voloviq/Laboratory_Power_Supply/Component_View/Lcd_Nokia_Navigator_Connector/DSCF1005.JPG

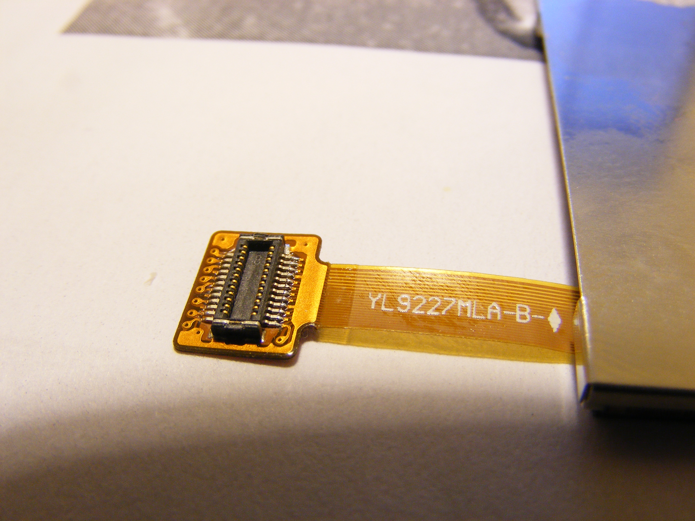
Component_View/Lcd_Nokia_Navigator_Connector/DSCF1005.JPG
