voloviq/Laboratory_Power_Supply/Software/Lcd_Menu/Key_And_Action.odt

Key and Actions functional description

Abstraction:

Function is responisble for analyze keyboard action and should take necessary preparation to proper manage menu structures of the device.

k_array[0] == 1 means pressed button number 1 (Menu)

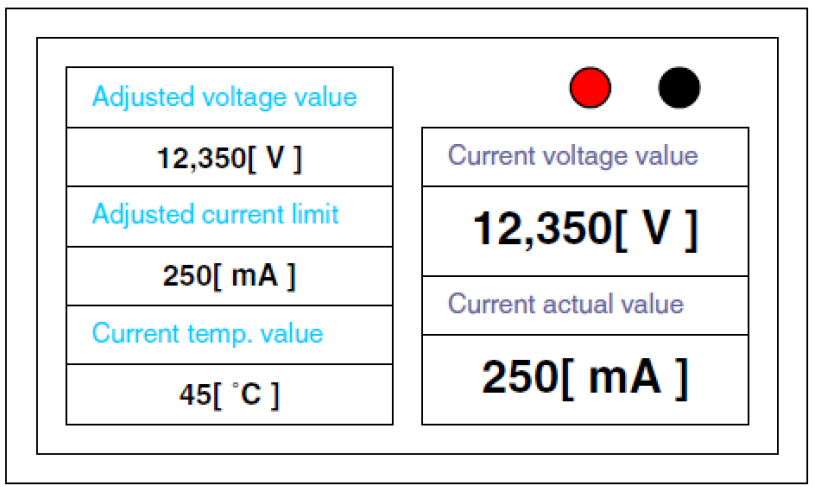
[picture p2: figure]

wr_sequencer == 0 means on display is exposed main menu structure

Algorithm:

Start

wr_sequencer == 1 means on display is exposed adjustable menu if ( wr_sequencer == 1 ) ClrScr(wr_sequencer); wr_sequencer++; if ( wr_sequencer == 0 ) if ( k_array[0] == 1 ) Function Key_state(...) take current keyboard action and storage it to k_array variable

Yes

Yes

No

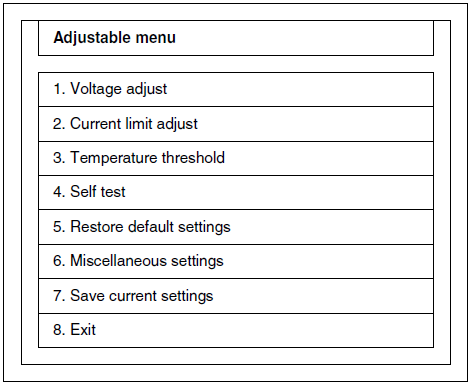
[picture p3: figure]

Show adjustable menu ClrScr(wr_sequencer); wr_sequencer = 0; Stop - Exit Show main menu if ( k_array[1] == 1 ) if ( k_array[2] == 1 ) if ( wr_sequencer == 2 )

No

No

Yes

No
