voloviq/Laboratory_Power_Supply/Software/Lcd_Menu/Key_And_Action_Algorithm_Block_Screen_C_Code.odt

Key and Actions functional description

Abstraction:

Function is responsible for analyze keyboard action and should take necessary preparation to proper manage menu structures of the device.

Screen 1Block screen relation between functional keys and LCD screens.

Complete dialog box is depicted below:

Menu - button Menu + button Menu + button Menu - button Menu + button Menu - button Menu + button Menu - button Menu - button Menu + button Menu - button Menu + button Menu + button Menu - button Menu + button Menu - button Save current settings Miscellaneous settings Restore def. settings Self test Temp. threshold Current limit Voltage Setup

Save

Misc.

Restore

Start test

85 [ºC]

12,5 [mA]

12,5 [V]


Screen 2

Screen 3

Screen 8

Screen 4

Screen 7

Screen 5

Screen 6

Screen 1 view explanation:

Current voltage measured on supply pins

Adjusted voltage value

Adjusted voltage

12,5 [V]

Current limit

200 [mA/A]

Temp 2N Trans.

85 [ºC]

Current voltage

Actual current

12,5 [V]

250[mA]

Adjusted current limit

Actual value of current which external device get from supply Temperature of 2N3055 main power transistor

Remark:

Only keys “menu +” and “menu -” work for this screen.

Screen 2 view explanation:

Key action befor „Menu +” First adjustable menu

Setup voltage

Voltage setup

12,5 [V]

Voltage setup To adjust first digit use „+” button and to change digit value use „Menu+” or „Menu-”. If You want to go back to previous screen press button „-”

12,5 [V]

To adjust second digit use „+” button and to change digit value use „Menu+” or „Menu-”. If You want to go back to previous digit press button „-”

Voltage setup

12,5 [V]

Voltage setup To adjust third digit use „+” button and to change digit value use „Menu+” or „Menu-”. If You want to go back to previous digit press button „-”

12,5 [V]

If type „+” button four time exist menu change and ask to save or not adujsted value. To save adujsted value type „+” button or „-” to discard. If you go to next screen type „Menu-” or „Menu+”

Do You want save adjustment

12,5 [V]

Remark:

Adjusted voltage may change according to range from 1[V] up to 30[V] with step 0,5 [V].
