voloviq/Laboratory_Power_Supply/External_Box_View/Front_Panel.pdf

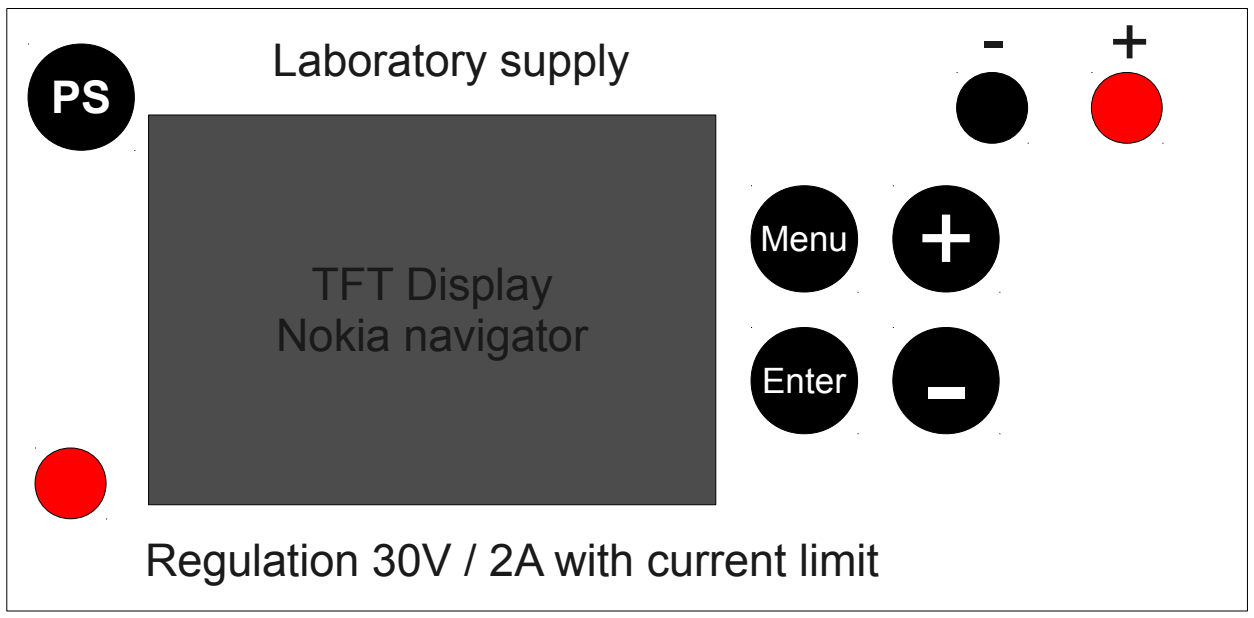
[picture p8: figure]
TFT Display Nokia navigator; Menu; Enter; Laboratory supply; Regulation 30V / 2A with current limit
