voloviq/Laboratory_Power_Supply/Software/Lcd_Connection/Lcd_Connection.pdf

## TFT Nokia Navigator Display

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
