voloviq/Laboratory_Power_Supply/Designing_Plan/Designing_Plan.xls

Enumerate | Topic | Necessary stuff | Necessary time to do | Remarks | Delay | Work complete
1 | Check Nokia N73 Display connector - detect where is located signals on connector | Display N73 + N73 Connector + Supplier | 2h | - | - | Done
2 | Check Atmel At91Sam7S128 which signal shall be used in project | Datasheet At91Sam7S128 | 8h | - | -
3 | Check SPI EEPROM how to connect to At91Sam7S128 | Datasheet SPI EEPROM | 2h | - | -
4 | Simulate analog part to project | LTSpice | 5h | - | -
5 | Choose supplier SMPS +8V/10VA | Nokia Serial Supplier | 4h | - | -
6 | Draw Scheme V1_0 | Kicad | 16h | - | -
7 | Check all outline in chassis | Chassis | 2h | - | -
8 | Draw PCB V1_0 | Kicad | 24h | - | -
9 | PCB Verification version V1_0 | Kicad | 8h | - | -
10 | Write software | Eclipse | 48h | - | -
11 | Finalize Scheme and PCB revision V1_0 | Only Document - summary | 4h | - | -
12 | Made any necessarry hardware modification | PCB | 8h | - | -
13 | Before hardware designe test AT91Sam7S128 write software | Eclipse rG-PCB-Development board | 16h | - | -
14
15
16
17
18
19
20
21
22
23
24
25
