voloviq/Laboratory_Power_Supply/Supplier_Main_Requirements/General_Requirements.odt

General requirement specification:

This document describe in detail and analyze each point come from User Specification and Conceptual Plan. Document shall describe all needed requirement concerning to design project.

Issue: 01a Document type: Requirement Specification Doc. type: GPL-MW2009-RS-01 Change date: 15/12/09 Time of change: 21:55:12 Subject: Refrigerator controller Author change: m.wolowik Doc. Rev.: 1.0 Author: Michal Wolowik Create date: 15-12-2009 Short destiny: Device shall drive refrigerator devi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

Site number: 1 Author: Michal Wolowik Doc. type: GPL-MW2009-RS-01
