voloviq/Laboratory_Power_Supply/Design_Calculation/TL431_Referential_Source_Calculation.xls

Obliczenia elementów źródła referencyjnego opartego o element TL431
Wzór na oblicznie napięcie referencyjnego U_Out_Ref przy znanych rezystorach R1 i R2 oraz R3 oraz prądzie I_Ref
U_Out_Ref[V] | U_Ref[V] | R1[Ω] | R2[Ω] | R3[Ω] | I_Ref [mA]
3.3 | 2.5 | 1504.094 | 4700 | 10 | -5e-05 | R3 | R1 | U_Out_Ref
 |  |  |  |  |  | 10 | 1504.094 | 3.3
Wzór na oblicznie rezystora R1 przy znanym rezystorze R2 oraz rezystorze R3 i prądzie I_Ref
U_Out_Ref[V] | U_Ref[V] | R1[Ω] | R2[Ω] | R3[Ω] | I_Ref [mA]
3.3 | 2.5 | 1504.094 | 4700 | 10 | -5e-05
 |  |  |  |  |  |  | R2
 |  |  |  |  |  |  | 4700
Uwagi:
Wartość prądu I_Ref została pozyskana z dokumentacji elementu TL431 i mieści się w zakresie (-0,05 ÷ 10) [mA].
