voloviq/Laboratory_Power_Supply/Design_Calculation/TL431_Resistor_Calculation/Tl431_Resistors_Calculation.ods

R2 value in Ohm | Calculated R1 value in Ohm
3300 | 314,9377593361
