voloviq/Laboratory_Power_Supply/Scheme_Pcb/Rev_V4_0/PCB_Component_Verification_Checklist_V4_0/PCB_V3_0_Checklist.xls

 |  |  | PCB Footprint component checklist Concering to revision V3_0
Item | Component name | Component Model / name / description | Component symbol In schematics | Component Parameter / value | Component package Kicad Propiretary library | Do Footprint in PCB figured to Appropriate compoent physicly | Reviewer name | Storage state | Component Review result 0 – negative result (red) 1 – positive result (green) | Remark | Document legend Blue color of field mean request must be rechecked Red color of field mean something is worng and must be check Green color of field mean request was checked and approve Magneta color mean that some information concernig Component must be correct. For instance component description
1 | Impulse Transformer | HH88A / Discrete | B1_S1 | Missing, orginaly used in SMPS | HH88A |  |  |  | 1 | Checked 7.XI.2010, Aligned pads via
2 | Capacitor | MLCC | C1 | 100nF | SM0805 |  |  |  | 1 | Checked 6.XI.2010, Aligned pads via
3 | Capacitor | Electrolitics / Discrete | C1_S1 | 2.2uF/400V | CAP_POL_8mm |  |  |  | 1 | Checked 6.XI.2010, Aligned pads via
4 | Capacitor | MLCC | C2 | 100nF | SM0805 |  |  |  | 1 | Checked 6.XI.2010, Aligned pads via
5 | Capacitor | Electrolitics / Discrete | C2_S1 | 47uF/50V | CAP_POL_6mm |  |  |  | 1 | Checked 6.XI.2010, Aligned pads via
6 | Capacitor | MLCC | C3 | 100nF | SMD1210Large |  |  |  | 1 | Checked 6.XI.2010, Aligned pads via
7 | Capacitor | Poliester / Discrete | C3_S1 | 3.3nF/1kV | CAP_PCK_5mm |  |  |  | 1 | Checked 7.XI.2010, Aligned pads via
8 | Capacitor | MLCC | C4 | 100nF | SM0805 |  |  |  | 1 | Checked 6.XI.2010, Aligned pads via
9 | Capacitor | Poliester / Discrete | C4_S1 | 1nF | CAP_PCK_2mm |  |  |  | 1 | Checked 7.XI.2010, Aligned pads via
10 | Capacitor | MLCC | C5 | 100nF | SM0805 |  |  |  | 1 | Checked 6.XI.2010, Aligned pads via
11 | Capacitor | Electrolitics / Discrete | C5_S1 | 16uF/16V | CAP_POL_4mm |  |  |  | 1 | Checked 6.XI.2010, Aligned pads via
12 | Capacitor | MLCC | C6 | 100nF | SM0805 |  |  |  | 1 | Checked 6.XI.2010, Aligned pads via
13 | Capacitor | Electrolitics / Discrete | C6_S1 | 100uF/16V | CAP_POL_6mm |  |  |  | 1 | Checked 7.XI.2010, Aligned pads via
14 | Capacitor | MLCC | C7 | 100nF | SM0805 |  |  |  | 1 | Checked 6.XI.2010, Checked SMD PCK
15 | Capacitor | MLCC | C8 | 100nF | SM1206 |  |  |  | 1 | Checked 6.XI.2010, Checked SMD PCK
16 | Capacitor | MLCC | C9 | 100nF | SM0805 |  |  |  | 1 | Checked 6.XI.2010, Checked SMD PCK
17 | Capacitor | MLCC | C10 | 68pF | SM0805 |  |  |  | 1 | Checked 6.XI.2010, Checked SMD PCK
18 | Capacitor | MLCC | C11 | 1nF | SM1206 |  |  |  | 1 | Checked 6.XI.2010, Checked SMD PCK
19 | Capacitor | MLCC | C12 | 10pF | SM0805 |  |  |  | 1 | Checked 6.XI.2010, Checked SMD PCK
20 | Capacitor | MLCC | C13 | 10pF | SM0805 |  |  |  | 1 | Checked 6.XI.2010, Checked SMD PCK
21 | Capacitor | MLCC | C14 | 100nF | SM0805 |  |  |  | 1 | Checked 6.XI.2010, Checked SMD PCK
22 | Capacitor | MLCC | C15 | 100nF | SM0805 |  |  |  | 1 | Checked 6.XI.2010, Checked SMD PCK
23 | Capacitor | MLCC | C19 | 100nF | SM1206 |  |  |  | 1 | Checked 6.XI.2010, Checked SMD PCK
24 | Capacitor | MLCC | C20 | 100nF | SM0805 |  |  |  | 1 | Checked 6.XI.2010, Checked SMD PCK
25 | Capacitor | Electrolitics / Discrete | C21 | 100uF/16V | CAP_POL_6mm |  |  |  | 1 | Checked 6.XI.2010, Aligned pads via
26 | Capacitor | Electrolitics / Discrete | C22 | 330uF/25V | CAP_POL_10mm |  |  |  | 1 | Checked 6.XI.2010, Aligned pads via
27 | Capacitor | Electrolitics / Discrete | C23 | 100uF/25V | CAP_POL_6mm |  |  |  | 1 | Checked 6.XI.2010, Aligned pads via
28 | Capacitor | Electrolitics / Discrete | C24 | 2200uF/50V | CAP_POL_18mm |  |  |  | 1 | Checked 6.XI.2010, Aligned pads via
29 | Capacitor | Electrolitics / Discrete | C25 | 10uF/16V | CAP_POL_6mm |  |  |  | 1 | Checked 6.XI.2010, Aligned pads via
30 | Capacitor | Electrolitics / Discrete | C26 | 100uF/6.3V | CAP_POL_6mm |  |  |  | 1 | Checked 6.XI.2010, Aligned pads via
31 | Capacitor | Electrolitics / Discrete | C27 | 10uF/6.3V | CAP_POL_6mm |  |  |  | 1 | Checked 6.XI.2010, Aligned pads via
32 | Capacitor | Electrolitics / Discrete | C29 | 100uF/6.3V | CAP_POL_6mm |  |  |  | 1 | Checked 6.XI.2010, Aligned pads via
33 | Capacitor | Electrolitics / Discrete | C30 | 10uF/6.3V | CAP_POL_6mm |  |  |  | 1 | Checked 6.XI.2010, Aligned pads via
34 | Capacitor | Electrolitics / Discrete | C31 | 100uF/6.3V | CAP_POL_6mm |  |  |  | 1 | Checked 6.XI.2010, Aligned pads via
35 | Capacitor | MLCC | C34 | 100nF | SM1206 |  |  |  | 1 | Checked 6.XI.2010, Checked SMD PCK
36 | Capacitor | Electrolitics / Discrete | C35 | 47uF/50V | CAP_POL_6mm |  |  |  | 1 | Checked 6.XI.2010, Aligned pads via
37 | Capacitor | Electrolitics / Discrete | C36 | 47uF/50V | CAP_POL_6mm |  |  |  | 1 | Checked 6.XI.2010, Aligned pads via
38 | Capacitor | Electrolitics / Discrete | C37 | 2200uF/35V | CAP_POL_16mm |  |  |  | 1 | Checked 6.XI.2010, Aligned pads via
39 | Capacitor | Electrolitics / Discrete | C38 | 470uF/50V | CAP_POL_10mm |  |  |  | 1 | Checked 6.XI.2010, Aligned pads via
40 | Capacitor | MLCC | C39 | 100nF | SM1206 |  |  |  | 1 | Checked 6.XI.2010, Checked SMD PCK
41 | Capacitor | MLCC | C40 | 100nF | SM1206 |  |  |  | 1 | Checked 6.XI.2010, Checked SMD PCK
42 | Capacitor | MLCC | C41 | 100pF | SM1206 |  |  |  | 1 | Checked 6.XI.2010, Checked SMD PCK
43 | Capacitor | MLCC | C42 | 330pF | SM1206 |  |  |  | 1 | Checked 6.XI.2010, Checked SMD PCK
44 | Capacitor | MLCC | C43 | 100pF | SM1206 |  |  |  | 1 | Checked 6.XI.2010, Checked SMD PCK
45 | Capacitor | Electrolitics / Discrete | C44 | 10uF/50V | CAP_POL_6mm |  |  |  | 1 | Checked 6.XI.2010, Aligned pads via
46 | Diode | Schottky Barrier Switching LL43 | D1 | 30V/200mA | SMD_DIODE_1206 |  |  |  | 1 | Checked 7.XI.2010, Checked SMD PCK
47 | Diode | Rectifier 1N4007 | D1_S1 | 1000V/1A | 1N4007 |  |  |  | 1 | Checked 6.XI.2010, Aligned pads via
48 | Diode | Schottky Barrier Rectifier SS14 | D2 | 20-100V/1A | DO-214AC |  |  |  | 1 | Checked 6.XI.2010, Checked SMD PCK
49 | Diode | Zener BZX55C12 | D2_S1 | 12V/40mA | D3 |  |  |  | 1 | Checked 6.XI.2010, Aligned pads via
50 | Diode | Rectifier Bridge KBL06 | D3 | 600V/4A | KBL06 |  |  |  | 1 | Checked 6.XI.2010, Aligned pads via
51 | Diode | Rectifier 1N4007 | D3_S1 | 1000V/1A | 1N4007 |  |  |  | 1 | Checked 6.XI.2010, Aligned pads via
52 | Diode | High Speed | D4_S1 | 75V/200mA | D3 |  |  |  | 1 | Checked 6.XI.2010, Aligned pads via
53 | Diode | Led HB5-132 Color RED | D5 | 5V/20mA | LED_5mm |  |  |  | 1 | Checked 6.XI.2010, Aligned pads via
54 | Diode | Ultra Fast Recovery Rectifier 1N5816 | D5_S1 | 105V/20A | 1N4007 |  |  |  | 1 | Checked 6.XI.2010, Aligned pads via
55 | Diode | Zener BZX55C3V3 | D7 | 3.3V/200mA | SMD_DIODE_1206 |  |  |  | 1 | Checked 6.XI.2010, Checked SMD PCK
56 | Diode | Zener BZX55C3V3 | D8 | 3.3V/200mA | SMD_DIODE_1206 |  |  |  | 1 | Checked 6.XI.2010, Checked SMD PCK
57 | Diode | Schottky Barrier Switching LL43 | D9 | 30V/200mA | SMD_DIODE_1206 |  |  |  | 1 | Checked 7.XI.2010, Checked SMD PCK
58 | Diode | Schottky Barrier Switching LL43 | D10 | 30V/200mA | SMD_DIODE_1206 |  |  |  | 1 | Checked 7.XI.2010, Checked SMD PCK
59 | Diode | Schottky Barrier Switching LL43 | D11 | 30V/200mA | SMD_DIODE_1206 |  |  |  | 1 | Checked 7.XI.2010, Checked SMD PCK
60 | Diode | Schottky Barrier Switching LL43 | D12 | 30V/200mA | SMD_DIODE_1206 |  |  |  | 1 | Checked 7.XI.2010, Checked SMD PCK
61 | Diode | Zener BZX55C5V6 | D13 | 5.6V/100mA | D3 |  |  |  | 1 | Checked 6.XI.2010, Aligned pads via
62 | Diode | Rectifier 1N4007 | D14 | 1000V/1A | 1N4007 |  |  |  | 1 | Checked 6.XI.2010, Aligned pads via
63 | Diode | Schottky Barrier Switching LL43 | D15 | 30V/200mA | SMD_DIODE_1206 |  |  |  | 1 | Checked 7.XI.2010, Checked SMD PCK
64 | Diode | Rectifier 1N4001 | D16 | 50V/1A | D3 |  |  |  | 1 | Checked 6.XI.2010, Aligned pads via
65 | Diode | Programmable Precision Reference TL431 | D17 | 36V/1-100mA | TL431 |  |  |  | 1 | Checked 6.XI.2010, Aligned pads via
66 | Fuse | Fuse F1 | F1 | 250V/2A | Fuse_Round |  |  |  | 1 | Checked 6.XI.2010, Aligned pads via
67 | USB | USB Connector | USB | Classical USBB socket | USB_B |  |  |  | 1 | Checked 6.XI.2010, Aligned pads via
68 | Connector | JTAG Connector | JP36 | Molex type connector | pin_array_4x2 |  |  |  | 1 | Checked 6.XI.2010, Aligned pads via
69 | Connector | Nokia N73 Universal Connector | JP40 | Nokia original connector | Nokia_N73 |  |  |  | 1 | Check layer and nokiac connector If no collision existe inside connector
70 | Connector | Power Connector | JP43 | Power Connector | POWER_CONNECTOR |  |  |  | 1 | Checked 7.XI.2010, Aligned pads via
71 | Connector | Power Connector | JP44 | PWR_GND | POWER_CONNECTOR |  |  |  | 1 | Checked 7.XI.2010, Aligned pads via
72 | Connector | Universal Connector | K1 | Temp_1 | PIN_ARRAY_3X1 |  |  |  | 1 | Checked 6.XI.2010, Aligned pads via
73 | Connector | Universal Connector | K2 | Temp_2 | PIN_ARRAY_3X1 |  |  |  | 1 | Checked 6.XI.2010, Aligned pads via
74 | Relay | Relay JZC-20F | K3 | 10ADC12V | JZC-20F |  |  |  | 1 | Checked 6.XI.2010, Aligned pads via
75 | Connector | Fan Cooler Connector | K4 | 12V/200mA max load | PIN_ARRAY_3X1 |  |  |  | 1 | Checked 6.XI.2010, Aligned pads via
76 | Connector | For 2N3055 connector only | K5 | For_2N3055 | bornier3 |  |  |  | 1 | Checked 7.XI.2010, Aligned pads via
77 | Inductor | Switching Regulator Inductor | L1 | 68uH/1A | SMD_INDUCTOR_680uH/1A |  |  |  | 1 | Checked 7.XI.2010, Aligned pads via
78 | Inductor | Filtering Component | L1_S1 | 68uH/1A | Inductor_2 |  |  |  | 1 | Checked 7.XI.2010, Aligned pads via
79 | Inductor | Switching Regulator Inductor | L2 | 100uH/100mA | SMT-4x3 |  |  |  | 1 | Checked 7.XI.2010, Checked SMD PCK
80 | Inductor | Filtering Component | L2_SUPP1 | 68uH/1A | SMD_INDUCTOR_680uH/1A |  |  |  | 1 | Checked 7.XI.2010, Checked SMD PCK
81 | Inductor | Filtering Component | L3 | 2x10mH/1.5A | INDUCTOR_RN122-1,5/02-2x10mH |  |  |  | 1 | Checked 7.XI.2010, Aligned pads via
82 | Connector | Signal and Powering Connector | P1 | Classic Gold Pin | PIN_ARRAY_8x2_Chassis |  |  |  | 1 | Checked 6.XI.2010, Aligned pads via
83 | Connector | Signal and Powering Connector | P2 | Classic Gold Pin | PIN_ARRAY_8x2_Chassis |  |  |  | 1 | Checked 6.XI.2010, Aligned pads via
84 | Connector | Main Transformer Connector | P2_SUPP1 | 230V_TR | bornier2 |  |  |  | 1 | Checked 7.XI.2010, Aligned pads via
85 | Connector | Main Power Connector | P3 | Output power connector max 30V/2A | Molex_2PIN_3,96 |  |  |  | 1 | Checked 6.XI.2010, Aligned pads via
86 | Connector | Secondary Windings Connector | P4 | SEC_WINDINGS | bornier4 |  |  |  | 1 | Checked 6.XI.2010, Aligned pads via
87 | Connector | Power Source and Switch On/Off Connection | P5 | FU_SW | bornier2 |  |  |  | 1 | Checked 6.XI.2010, Aligned pads via
88 | Connector | Main power Source Connector | P6 | 230[V]_S | bornier2 |  |  |  | 1 | Checked 6.XI.2010, Aligned pads via
89 | Connector | Main Power Connector | P7 | Output power connector max 30V/2A | Molex_2PIN_3,96 |  |  |  | 1 | Checked 6.XI.2010, Aligned pads via
90 | Transistor | Main Power Transistor 2N3055 | Q1 | 100V/15A | bornier3 |  |  |  | 1 | Checked 6.XI.2010, Aligned pads via
91 | Transistor | Switching Regulator Transistor 13001 | Q1_S1 | 400V/300mA | to92-1 |  |  |  | 1 | Checked 6.XI.2010, Aligned pads via
92 | Transistor | Universal NPN Transistor BC846 | Q2 | 80V/100mA | SOT23_EBC |  |  |  | 1 | Checked 6.XI.2010, Checked SMD PCK
93 | Transistor | MOSFET P-Channel Transistor IRFU9024N | Q3 | 55V/11A | TO-251AA |  |  |  | 1 | Checked 6.XI.2010, Aligned pads via
94 | Transistor | 2N3055 Driver Transistor BD139 | Q4 | 80V/1.5A | TO-126 |  |  |  | 1 | Checked 6.XI.2010, Aligned pads via
95 | Transistor | Universal NPN Transistor BC846 | Q5 | 80V/100mA | SOT23_EBC |  |  |  | 1 | Checked 6.XI.2010, Checked SMD PCK
96 | Transistor | Universal NPN Transistor BC846 | Q6 | 80V/100mA | SOT23_EBC |  |  |  | 1 | Checked 6.XI.2010, Checked SMD PCK
97 | Transistor | Universal NPN Transistor BC846 | Q7 | 80V/100mA | SOT23_EBC |  |  |  | 1 | Checked 6.XI.2010, Checked SMD PCK
98 | Transistor | Destination of this Transistor is Package Only | Q8 | 100V/15A | TO3 |  |  |  | 1 | Checked 6.XI.2010, Aligned pads via
99 | Resistor | SMD Resistor | R1 | 10k | SM0805 |  |  |  | 1 | Checked 6.XI.2010, Checked SMD PCK
100 | Resistor | Discrete Resistor | R1_S1 | 1R | Res_discr_9mm |  |  |  | 1 | Checked 6.XI.2010, Aligned pads via
101 | Resistor | SMD Resistor | R2 | 10k | SM0805 |  |  |  | 1 | Checked 6.XI.2010, Checked SMD PCK
102 | Resistor | Discrete Resistor | R2_S1 | 1R | Res_discr_9mm |  |  |  | 1 | Checked 6.XI.2010, Aligned pads via
103 | Resistor | SMD Resistor | R3 | 10k | SM0805 |  |  |  | 1 | Checked 6.XI.2010, Checked SMD PCK
104 | Resistor | Discrete Resistor | R3_S1 | 30R | Res_discr_9mm |  |  |  | 1 | Checked 6.XI.2010, Aligned pads via
105 | Resistor | SMD Resistor | R4 | 10k | SM0805 |  |  |  | 1 | Checked 6.XI.2010, Checked SMD PCK
106 | Resistor | Discrete Resistor | R4_S1 | 10k | Res_discr_9mm |  |  |  | 1 | Checked 6.XI.2010, Aligned pads via
107 | Resistor | SMD Resistor | R5 | 10k | SM1206 |  |  |  | 1 | Checked 6.XI.2010, Aligned pads via
108 | Resistor | Discrete Resistor | R5_S1 | 10k | Res_discr_9mm |  |  |  | 1 | Checked 6.XI.2010, Aligned pads via
109 | Resistor | SMD Resistor | R6 | 1k | SM1206 |  |  |  | 1 | Checked 6.XI.2010, Aligned pads via
110 | Resistor | Discrete Resistor | R6_S1 | 67k | Res_discr_9mm |  |  |  | 1 | Checked 6.XI.2010, Aligned pads via
111 | Resistor | SMD Resistor | R7 | 10k | SM0805 |  |  |  | 1 | Checked 6.XI.2010, Checked SMD PCK
112 | Resistor | Discrete Resistor | R7_S1 | 30R | Res_discr_9mm |  |  |  | 1 | Checked 6.XI.2010, Aligned pads via
113 | Resistor | SMD Resistor | R8 | 150R | SM1206 |  |  |  | 1 | Checked 6.XI.2010, Aligned pads via
114 | Resistor | Discrete Resistor | R8_S1 | 2k | Res_discr_9mm |  |  |  | 1 | Checked 6.XI.2010, Aligned pads via
115 | Resistor | SMD Resistor | R9 | 100k | SM1206 |  |  |  | 1 | Checked 6.XI.2010, Aligned pads via
116 | Resistor | SMD Resistor | R10 | 100k | SM0805 |  |  |  | 1 | Checked 6.XI.2010, Checked SMD PCK
117 | Resistor | SMD Resistor | R11 | 100k | SM0805 |  |  |  | 1 | Checked 6.XI.2010, Checked SMD PCK
118 | Resistor | SMD Resistor | R12 | 100k | SM1206 |  |  |  | 1 | Checked 6.XI.2010, Aligned pads via
119 | Resistor | SMD Resistor | R13 | 100k | SM0805 |  |  |  | 1 | Checked 6.XI.2010, Checked SMD PCK
120 | Resistor | SMD Resistor | R14 | 1M | SM1206 |  |  |  | 1 | Checked 6.XI.2010, Aligned pads via
121 | Resistor | SMD Resistor | R15 | 1k | SM1206 |  |  |  | 1 | Checked 6.XI.2010, Aligned pads via
122 | Resistor | SMD Resistor | R16 | 1k | SM1206 |  |  |  | 1 | Checked 6.XI.2010, Aligned pads via
123 | Resistor | SMD Resistor | R17 | 1M | SM1206 |  |  |  | 1 | Checked 6.XI.2010, Aligned pads via
124 | Resistor | SMD Resistor | R18 | 100k | SM1206 |  |  |  | 1 | Checked 6.XI.2010, Aligned pads via
125 | Resistor | SMD Resistor | R19 | 100k | SM1206 |  |  |  | 1 | Checked 6.XI.2010, Aligned pads via
126 | Resistor | SMD Resistor | R20 | 10k | SM1206 |  |  |  | 1 | Checked 6.XI.2010, Aligned pads via
127 | Resistor | SMD Resistor | R21 | 10k | SM1206 |  |  |  | 1 | Checked 6.XI.2010, Aligned pads via
128 | Resistor | Discrete Resistor | R22 | 0R1 | Res_2 |  |  |  | 1 | Checked 6.XI.2010, Aligned pads via
129 | Resistor | SMD Resistor | R23 | 33k | SM1206 |  |  |  | 1 | Checked 6.XI.2010, Aligned pads via
130 | Resistor | SMD Resistor | R24 | 2k7 | SM1206 |  |  |  | 1 | Checked 6.XI.2010, Aligned pads via
131 | Resistor | SMD Resistor | R25 | 1k | SM1206 |  |  |  | 1 | Checked 6.XI.2010, Aligned pads via
132 | Resistor | SMD Resistor | R26 | 1k | SM1206 |  |  |  | 1 | Checked 6.XI.2010, Aligned pads via
133 | Resistor | Discrete Resistor | R27 | 0R22 | Res_1 |  |  |  | 1 | Checked 6.XI.2010, Aligned pads via
134 | Resistor | SMD Resistor | R28 | 1k | SM1206 |  |  |  | 1 | Checked 6.XI.2010, Aligned pads via
135 | Resistor | SMD Resistor | R29 | 180R | SM1206 |  |  |  | 1 | Checked 6.XI.2010, Aligned pads via
136 | Resistor | SMD Resistor | R30 | 11k | SM1206 |  |  |  | 1 | Checked 6.XI.2010, Aligned pads via
137 | Resistor | SMD Resistor | R31 | 2k7 | SM1206 |  |  |  | 1 | Checked 6.XI.2010, Aligned pads via
138 | Resistor | SMD Resistor | R32 | 4k3 | SM1206 |  |  |  | 1 | Checked 6.XI.2010, Aligned pads via
139 | Resistor | SMD Resistor | R33 | 2k7 | SM1206 |  |  |  | 1 | Checked 6.XI.2010, Aligned pads via
140 | Resistor | SMD Resistor | R34 | 2k7 | SM1206 |  |  |  | 1 | Checked 6.XI.2010, Aligned pads via
141 | Resistor | SMD Resistor | R35 | 3k3 | SM1206 |  |  |  | 1 | Checked 6.XI.2010, Aligned pads via
142 | Resistor | SMD Resistor | R36 | 1k5 | SM1206 |  |  |  | 1 | Checked 6.XI.2010, Aligned pads via
143 | Resistor | SMD Resistor | R37 | 150R | SM0805 |  |  |  | 1 | Checked 6.XI.2010, Checked SMD PCK
144 | Resistor | SMD Resistor | R38 | Rext | SM0805 |  |  |  | 1 | Resistance must be calculated
145 | Resistor | SMD Resistor | R39 | Rext | SM0805 |  |  |  | 1 | Resistance must be calculated
146 | Resistor | SMD Resistor | R40 | 330k | SM0805 |  |  |  | 1 | Checked 6.XI.2010, Checked SMD PCK
147 | Resistor | SMD Resistor | R41 | 330k | SM0805 |  |  |  | 1 | Checked 6.XI.2010, Checked SMD PCK
148 | Resistor | SMD Resistor | R42 | 1k5 | SM0805 |  |  |  | 1 | Checked 6.XI.2010, Checked SMD PCK
149 | Resistor | SMD Resistor | R43 | 27k | SM0805 |  |  |  | 1 | Checked 6.XI.2010, Checked SMD PCK
150 | Resistor | SMD Resistor | R44 | 47k | SM0805 |  |  |  | 1 | Checked 6.XI.2010, Checked SMD PCK
151 | Resistor | SMD Resistor | R45 | 4k7 | SM0805 |  |  |  | 1 | Checked 6.XI.2010, Checked SMD PCK
152 | Resistor | SMD Resistor | R48 | 1k | SM1206 |  |  |  | 1 | Checked 6.XI.2010, Aligned pads via
153 | Resistor | SMD Resistor | R49 | 10k | SM1206 |  |  |  | 1 | Checked 6.XI.2010, Aligned pads via
154 | Resistor | SMD Resistor | R50 | 1k | SM1206 |  |  |  | 1 | Checked 6.XI.2010, Aligned pads via
155 | Resistor | SMD Resistor | R51 | 10k | SM1206 |  |  |  | 1 | Checked 6.XI.2010, Aligned pads via
156 | Resistor | SMD Resistor | R52 | 24k | SM1206 |  |  |  | 1 | Checked 6.XI.2010, Aligned pads via
157 | Resistor | SMD Resistor | R53 | 3k3 | SM1206 |  |  |  | 1 | Checked 6.XI.2010, Aligned pads via
158 | Resistor | SMD Resistor | R54 | 2k2 | SM1206 |  |  |  | 1 | Checked 6.XI.2010, Aligned pads via
159 | Resistor | SMD Resistor | R55 | 560k | SM1206 |  |  |  | 1 | Checked 6.XI.2010, Aligned pads via
160 | Resistor | SMD Resistor | R56 | 47k | SM1206 |  |  |  | 1 | Checked 6.XI.2010, Aligned pads via
161 | Resistor | SMD Resistor | R57 | 47R | SM1206 |  |  |  | 1 | Checked 6.XI.2010, Aligned pads via
162 | Resistor | SMD Resistor | R58 | 4k7 | SM1206 |  |  |  | 1 | Checked 6.XI.2010, Aligned pads via
163 | Resistor | SMD Resistor | R59 | 47R | SM1206 |  |  |  | 1 | Checked 6.XI.2010, Aligned pads via
164 | Resistor | SMD Resistor | R61 | 82R | SM1206 |  |  |  | 1 | Checked 6.XI.2010, Aligned pads via
165 | Resistor | SMD Resistor | R62 | 220R | SM1206 |  |  |  | 1 | Checked 6.XI.2010, Aligned pads via
166 | Resistor | SMD Resistor | R63 | 1k5 | SM1206 |  |  |  | 1 | Checked 6.XI.2010, Aligned pads via
167 | Resistor | SMD Resistor | R64 | 10k | SM1206 |  |  |  | 1 | Checked 6.XI.2010, Aligned pads via
168 | Resistor | SMD Resistor | R65 | 100R | SM1206 |  |  |  | 1 | Checked 6.XI.2010, Aligned pads via
169 | Resistor | SMD Resistor | R66 | R | SM1206 |  |  |  | 1 | Resistance must be calculated
170 | Resistor | SMD Resistor | R67 | R | SM1206 |  |  |  | 1 | Resistance must be calculated
171 | Resistor | Discrete Potentiometer | RV1 | 10k | POT_1 |  |  |  | 1 | Checked 6.XI.2010, Aligned pads via
172 | Resistor | Discrete Potentiometer | RV1 | 10k | POT_1 |  |  |  | 1 | Checked 6.XI.2010, Aligned pads via
173 | Switch | Function Button | S1 | TACT-24R | TACT-24R |  |  |  | 1 | Checked 7.XI.2010, Aligned pads via
174 | Switch | Function Button | S2 | TACT-24R | TACT-24R |  |  |  | 1 | Checked 7.XI.2010, Aligned pads via
175 | Switch | Function Button | S3 | TACT-24R | TACT-24R |  |  |  | 1 | Checked 7.XI.2010, Aligned pads via
176 | Switch | Function Button | S4 | TACT-24R | TACT-24R |  |  |  | 1 | Checked 7.XI.2010, Aligned pads via
177 | Switch | Function Button | S5 | TACT-24R | TACT-24R |  |  |  | 1 | Checked 7.XI.2010, Aligned pads via
178 | Transformer | Main Power Transformer | T1 | TST_50/004 | TST50_004 |  |  |  | 1 | Checked 6.XI.2010
179 | Integrated Circuit | Flash Memory | U1 | AT45DB161D | SOIC8 |  |  |  | 1 | Checked 6.XI.2010, Aligned pads via
180 | Integrated Circuit | Operational Amplifier LM358 | U2 | LM358 | 8DIP-ELL300 |  |  |  | 1 | Checked 6.XI.2010, Aligned pads via
181 | Integrated Circuit | Switching Regulator MC34063 | U4 | MC34063 | SO8E |  |  |  | 1 | Checked 6.XI.2010, Aligned pads via
182 | Integrated Circuit | Translating Transceiver 74LVC4245A | U5 | 74LVC4245AD | SO24 |  |  |  | 1 | Checked 6.XI.2010, Checked SMD PCK
183 | Integrated Circuit | Translating Transceiver 74LVC4245A | U6 | 74LVC4245AD | SO24 |  |  |  | 1 | Checked 6.XI.2010, Checked SMD PCK
184 | Integrated Circuit | Linear Regulator LM1117 | U7 | LM1117 | DPAK2 |  |  |  | 1 | Checked 6.XI.2010, Checked SMD PCK
185 | Integrated Circuit | Linear Regulator LM1117 | U8 | LM1117 | DPAK2 |  |  |  | 1 | Checked 6.XI.2010, Checked SMD PCK
186 | Integrated Circuit | Linear Regulator LM1117 | U9 | LM1117 | DPAK2 |  |  |  | 1 | Checked 6.XI.2010, Checked SMD PCK
187 | Integrated Circuit | Operational Amplifier OP07 | U12 | OP07 | 8DIP-ELL300 |  |  |  | 1 | Checked 6.XI.2010, Aligned pads via
188 | Integrated Circuit | Operational Amplifier OP07 | U13 | OP07 | 8DIP-ELL300 |  |  |  | 1 | Checked 6.XI.2010, Aligned pads via
189 | Microcontroller | Main Microcontroller AT91SAM7S128 | uC1 | AT912SAM7S128 | LQPF_64_Atmel |  |  |  | 1 | Checked 6.XI.2010, Checked SMD PCK
190 | Resonator | Quartz Resonator | X1 | 14.7456MHz | Xtal_SMD_Classic_1 |  |  |  | 1 | Checked 6.XI.2010, Checked SMD PCK
