voloviq/Laboratory_Power_Supply/Problem_Reports/Problem_Report_Idx/CD4538_Calculation.ods

Pulse width calculation for CD4538
Cx | Rx | Time | VDD value | Real time
1,00E-009 | 1,00E+004 | 0,00001 | 12[V]
Capacitor value calculation for CD4538
Time | Rx | Cx | VDD value | Real time
2,00E-002 | 1,00E+005 | 0,0000002 | 12[V]
To obtain 1[us] pulse width Rx=10kOhm and Cx=100[pF]
 |  |  | Note:
 |  |  | The maximum usable resistance RX is a function of the leakage of the Capacitor CX, Leakage of the CD4538BC, and leakage due To board layout, surface resistance, etc.
