voloviq/Laboratory_Power_Supply/Problem_Reports/Problem_Report_Idx/CD4538_Picture.jpeg

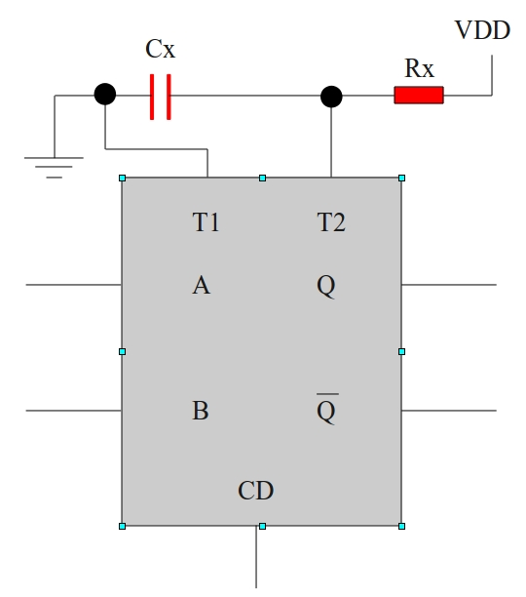
Problem_Reports/Problem_Report_Idx/CD4538_Picture.jpeg
