voloviq/Laboratory_Power_Supply/Problem_Reports/V2_0_Pcb.pdf

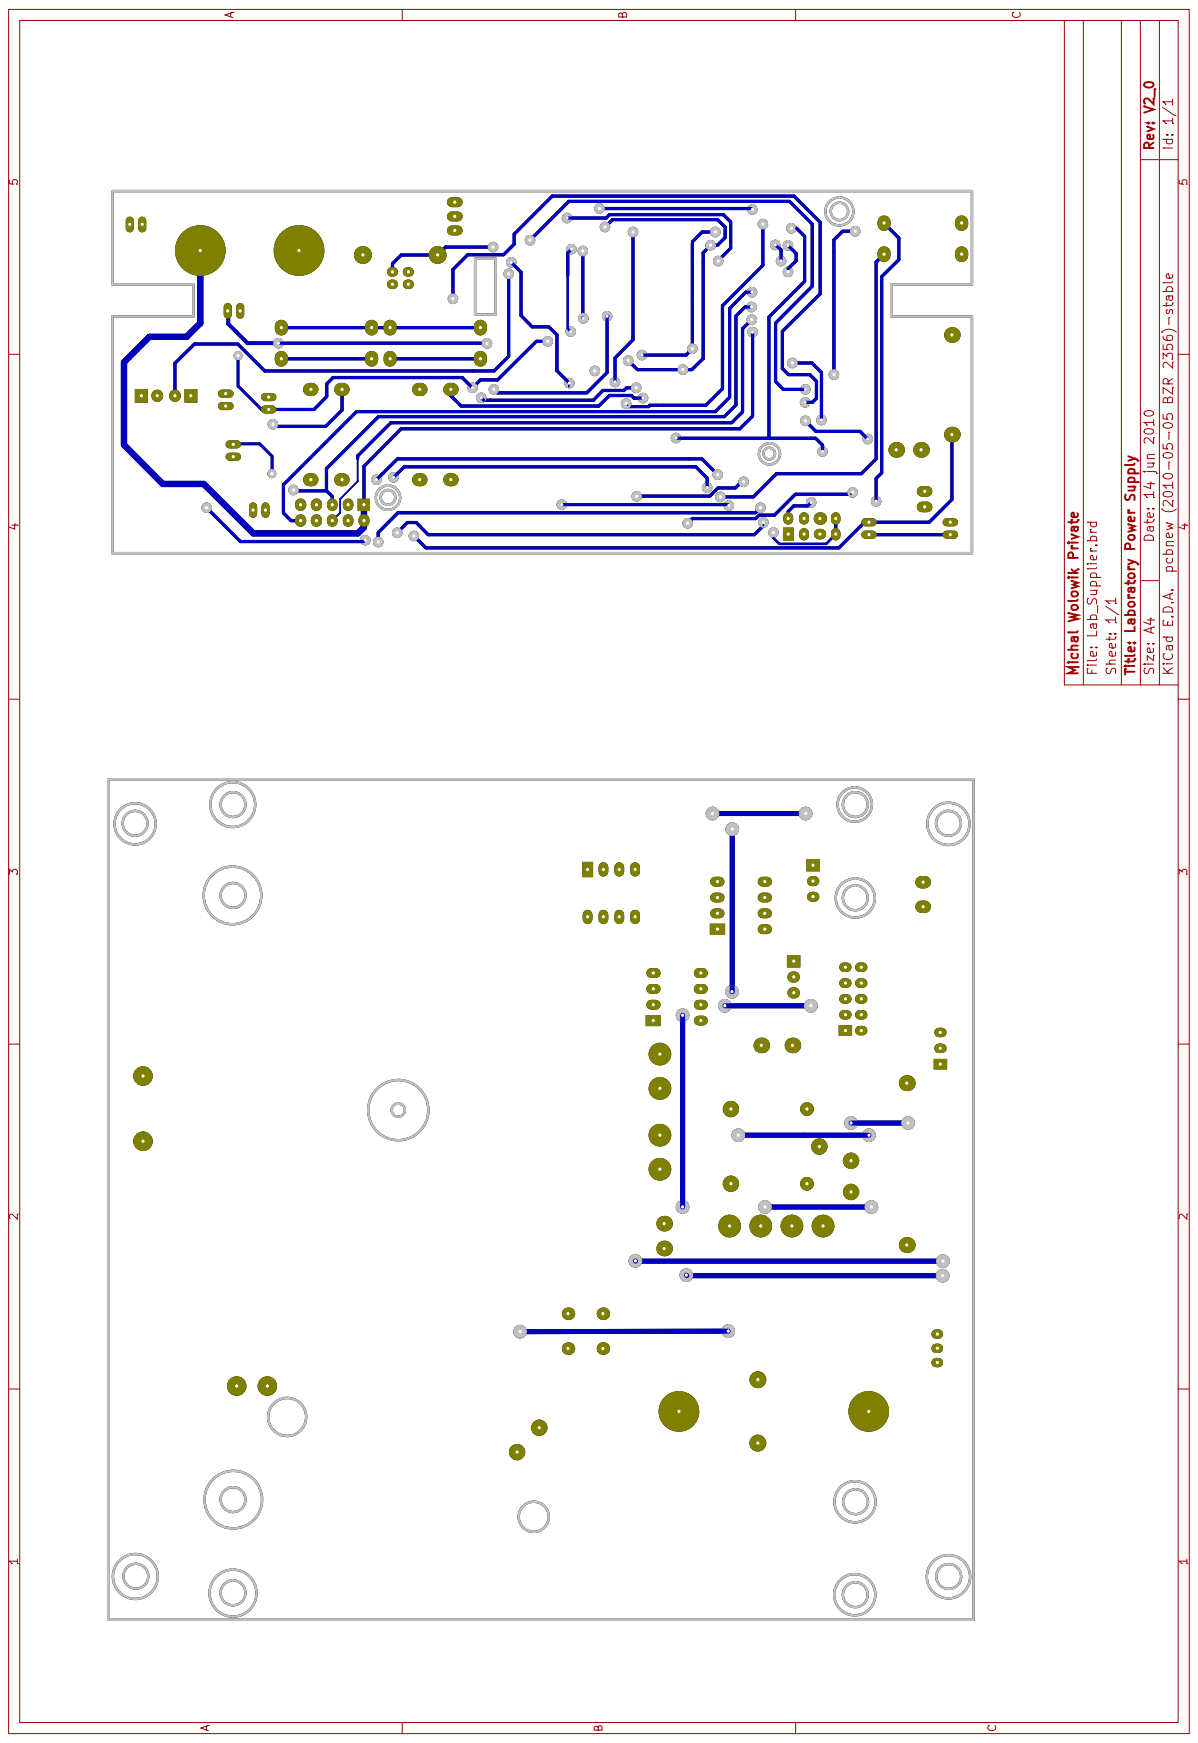
[picture p17: page 1]

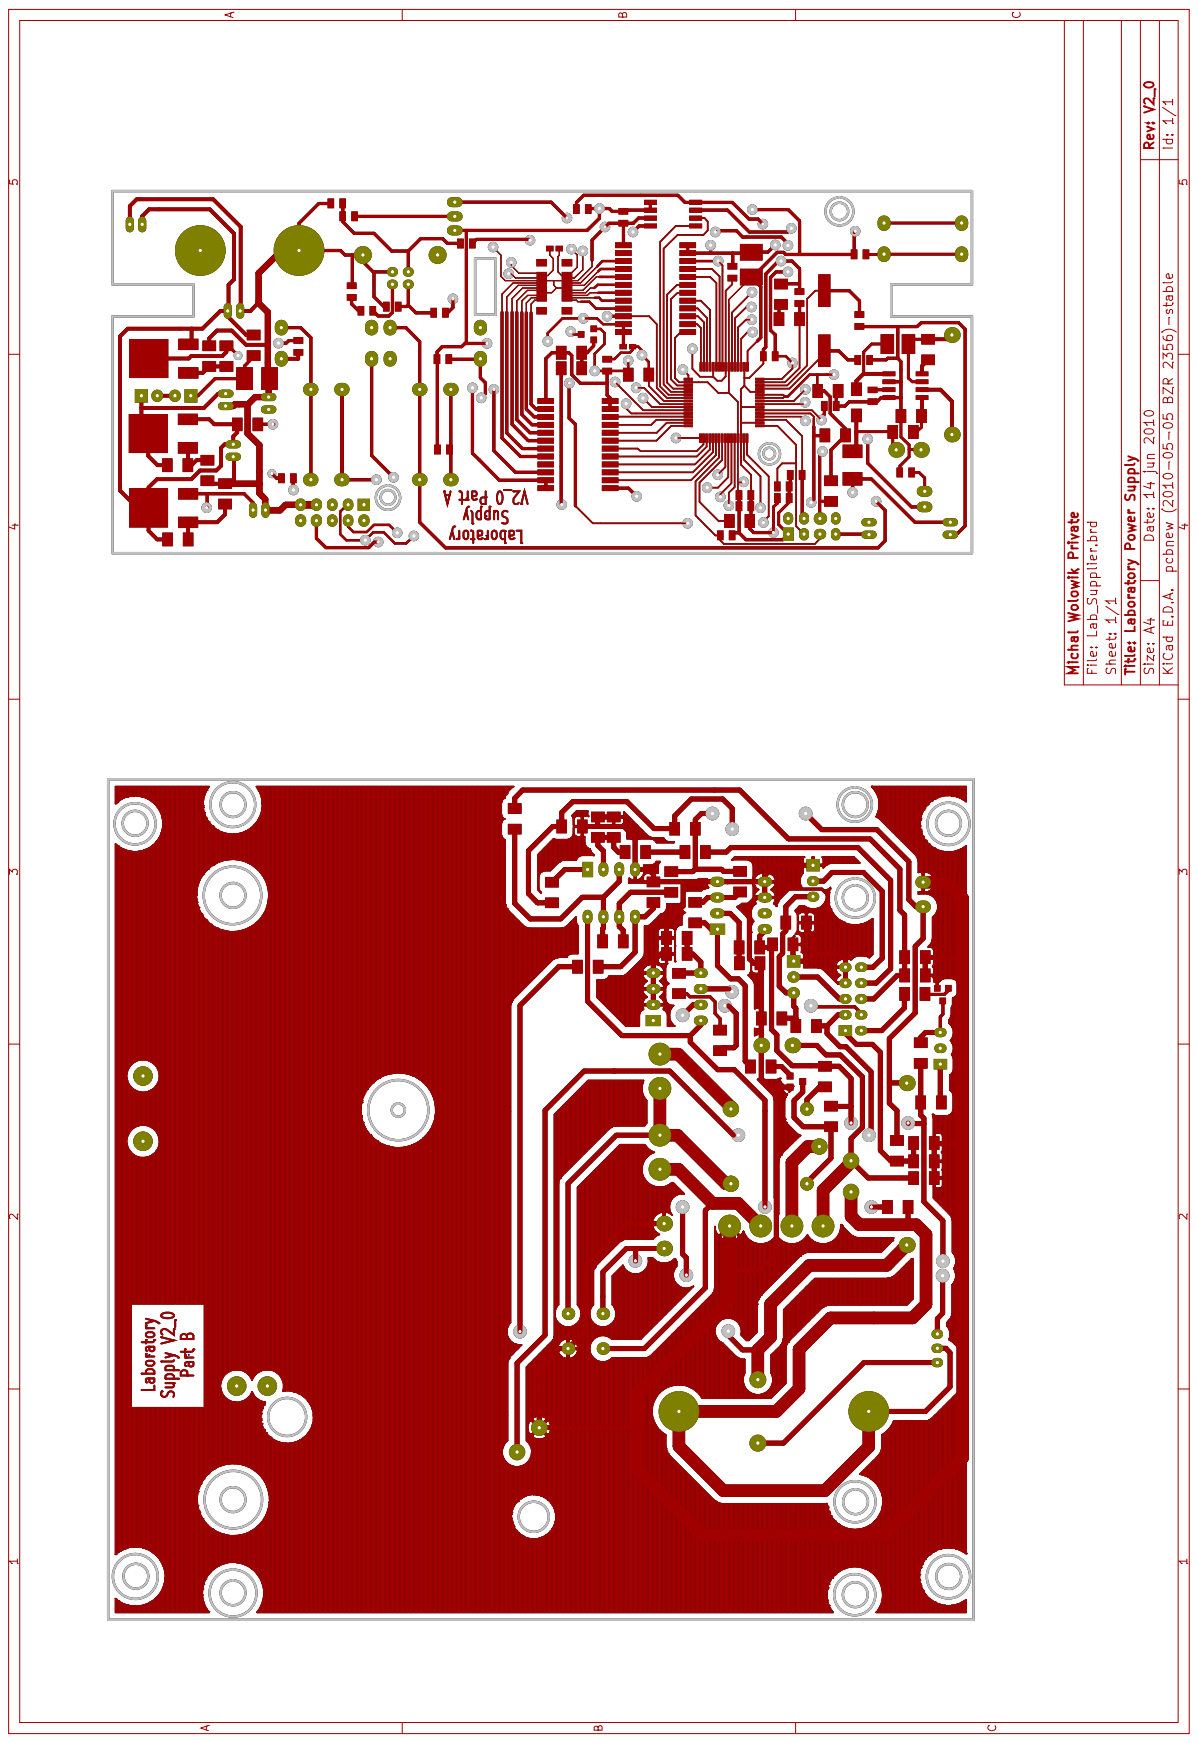
[picture p18: page 2]

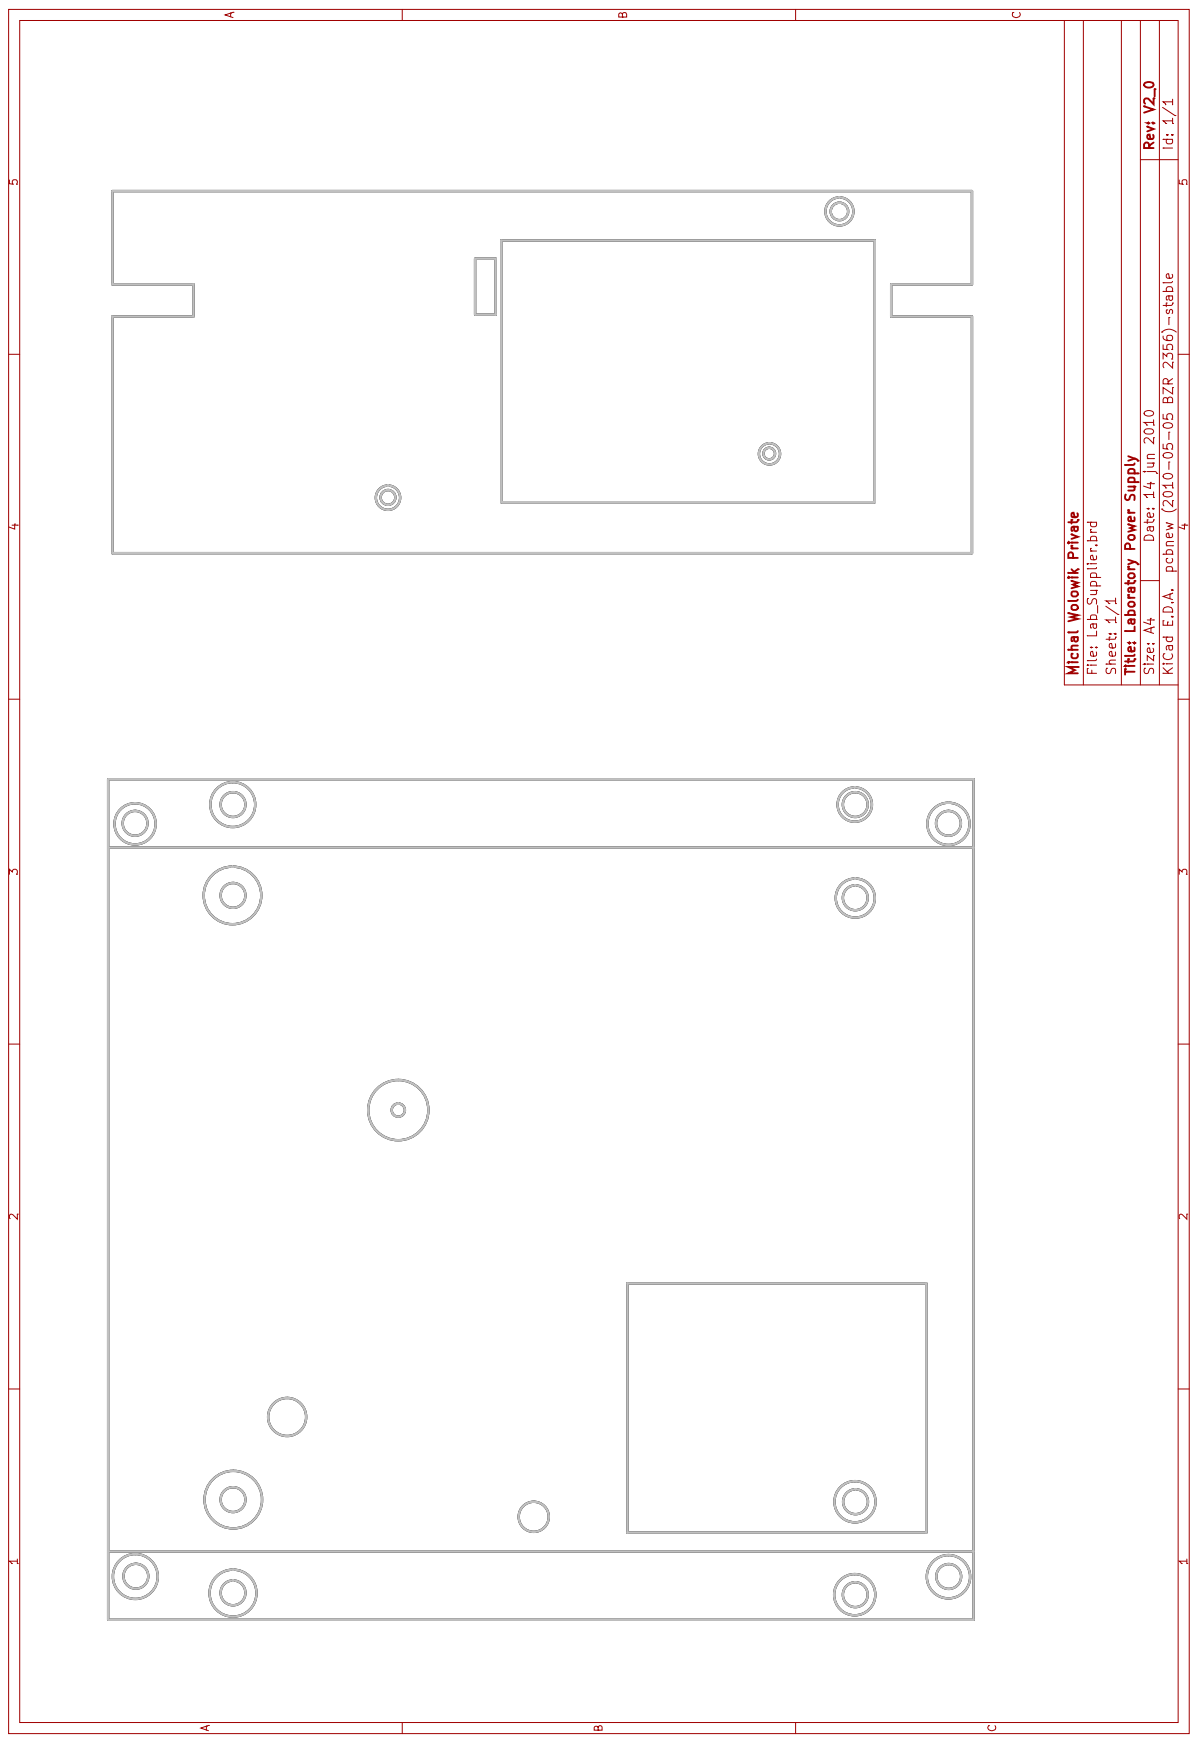
[picture p19: page 3]

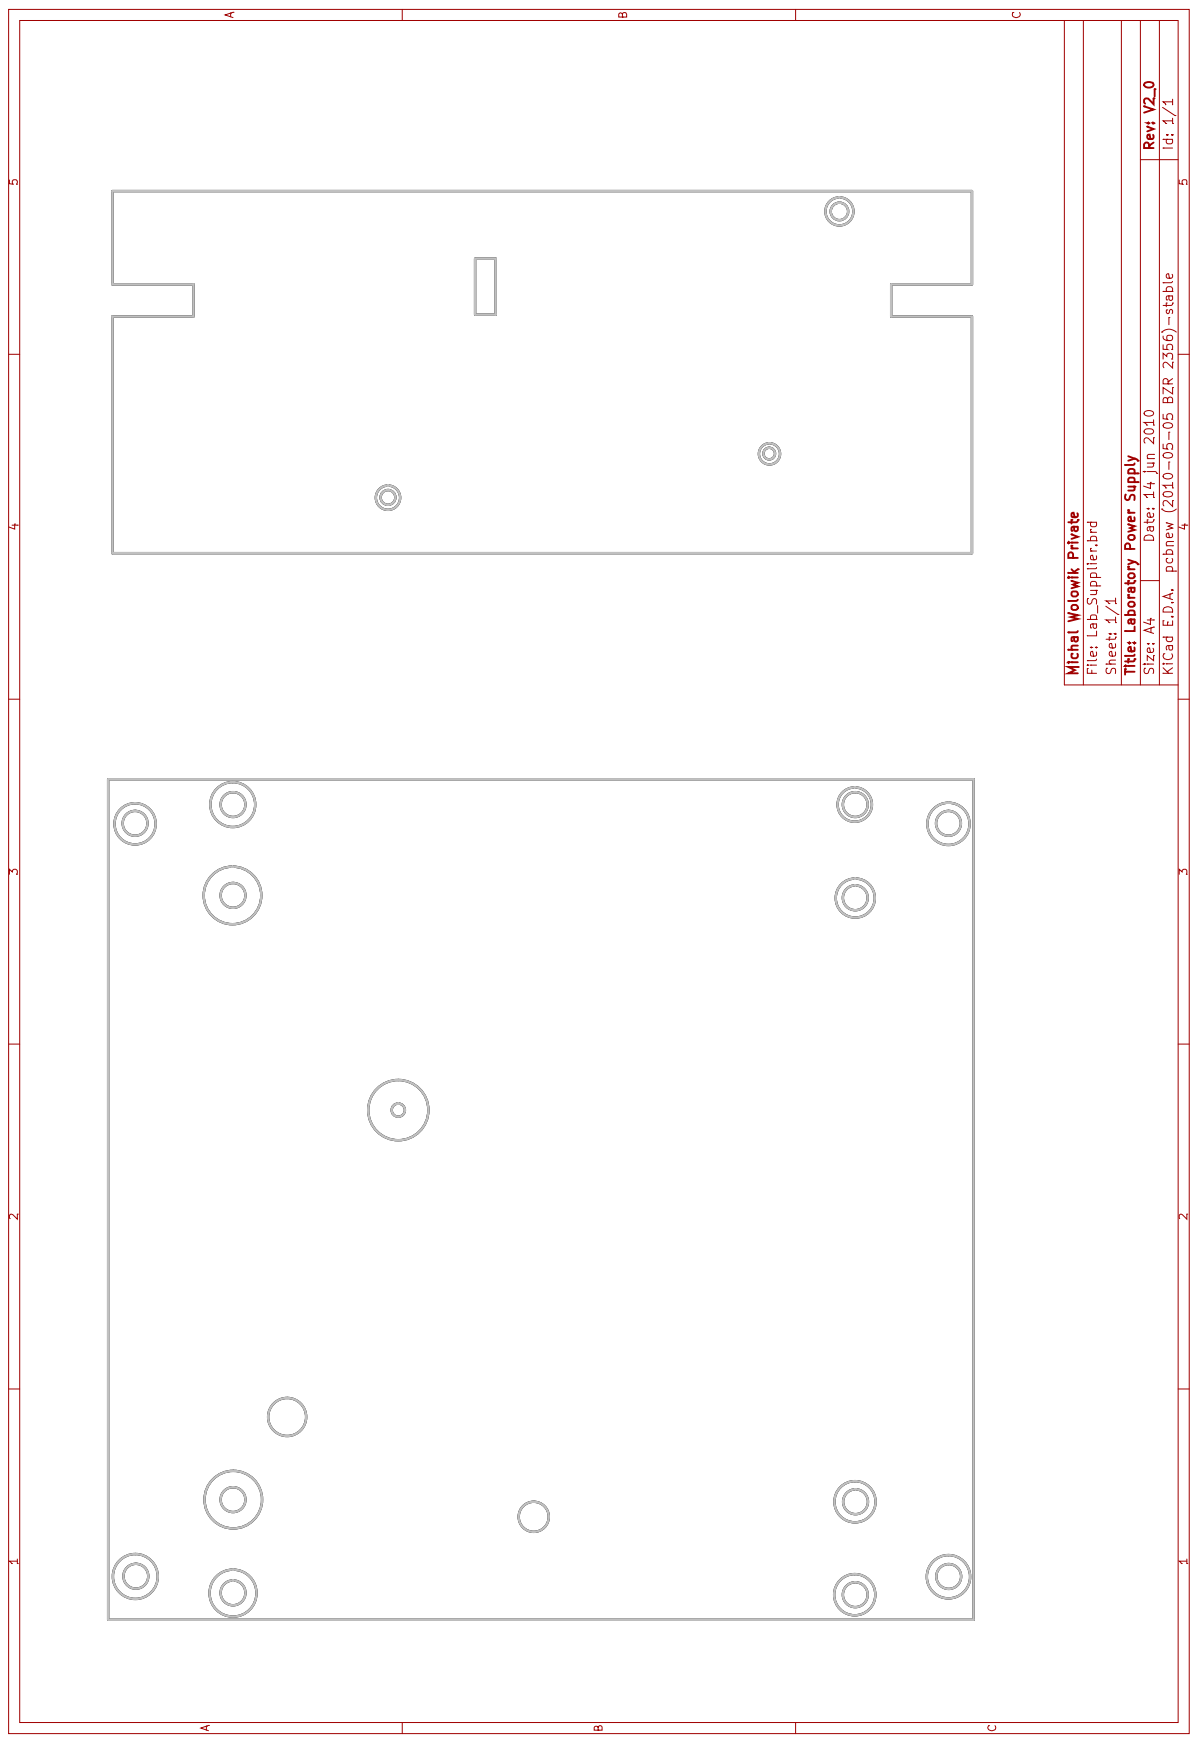
[picture p20: page 4]
