voloviq/Laboratory_Power_Supply/Analog_Circuit_Simulation_LTSpice/Supplier_V1_0.asc

C1: cap; 100nF
C2: cap; 1µF
D1: diode
Q1: npn; BC547B
Q2: npn; 2N3055
R1: res; 0R1
R2: res; 27k
R3: res; 15k
R4: res; 10k
R5: res; 10k
R6: res; 33k
R7: res; 2k7
R8: res; 100R; tol=20
R9: res; 100k
R10: res; 100k
R11: res; 1k
R12: res; 2k2
U1: op07
U2: op07
U3: lm358
V1: voltage; 1
V2: voltage; 32V
V3: voltage; 130mV
V4: voltage; 5V
V5: voltage; 35V
Named nets: 0, OUT, VCC, VSS, VPP
.tran 0 1m 100u 1m
