voloviq/Laboratory_Power_Supply/Design_Calculation/LC_Filtr_Simulation/Filtr_LC_Supply.asc

C1: cap; 2200µF
C2: cap; 2200µF
D1: diode
D2: diode
D3: diode
D4: diode
L1: ind; 20mH
R1: res; 3R
V1: voltage; SINE(0 12 100)
Named nets: 0, Out
.tran 0 5 .1m 10m
