voloviq/Laboratory_Power_Supply/Analog_Circuit_Simulation_LTSpice/LC_Filter.asc

C1: cap; 100µ
L1: ind; 22µ
V1: voltage; PULSE(11 11.5 0 0.01u 0.01u 1u 6.41u)
Named nets: 0
.tran 0 100m 0.1u 1u
