voloviq/Laboratory_Power_Supply/Analog_Circuit_Simulation_LTSpice/Low_Pass_Filter.asc

C2: cap; 320n
R1: res; 10k
R2: res; 1Meg
V1: voltage; PULSE(0 3 0 0.1u 0.1u 19u 20u)
Named nets: 0, Input, OUTPUT
.tran 0 3s 0.1m 100m
