voloviq/Laboratory_Power_Supply/Analog_Circuit_Simulation_LTSpice/Current_Circuit/CC.asc

R1: res; 0R1
R2: res; 33k
R3: res; 2k7
R4: res; 460
R5: res; 10k
R6: res; 10k
R7: res; 100k
R8: res; 100k
R9: res; 30R
R10: res; 5k
R11: res; 5k
U1: LT1128
V1: voltage; 32V
V2: voltage; 5
Named nets: 0, V+, V-, OUT
.tran 0 2 .1m .1
