voloviq/Laboratory_Power_Supply/Analog_Circuit_Simulation_LTSpice/Current_Limiter/Cur_lm.asc

Q1: pnp; BC557C
R1: res; 1k
R2: res; 100k
R3: res; 1k
U1: lm358
V1: voltage; 12
V2: voltage; 2
V3: voltage; PWL(0.1 2.0 0.2 1.0 0.35 2.0 0.4 1.0 0.5 1.5 0.6 1.0 0.7 1.5 0.8 1.0 0.9 1.5 1.0 1.0 1.1 1.5 1.2 1.0 1.3 1.5)
V4: voltage; 12
Named nets: 0, Output, From_Current_Measure_Circuit, Threshold_Adjustment
.tran 0 2 1 1m
