voloviq/Laboratory_Power_Supply/Analog_Circuit_Simulation_LTSpice/Current_Limiter/Cur_Lm_01A.asc

C1: cap; 100nF
Q1: npn; BC547B
R1: res; 1k
R3: res; 1Meg
R4: res; 10k
R5: res; 1k
U1: lm358
V1: voltage; 12V
V2: voltage; 1
Named nets: 0, Output
.tran 0 2 1m 1m
