voloviq/Laboratory_Power_Supply/Analog_Circuit_Simulation_LTSpice/Lm358_Comparator_Calculation/LM358_Cmp.asc

D1: zener; BZX84C12L
D2: zener; BZX84C12L
D4: zener; BZX84C12L
Q1: npn; BC847B
R1: res; 15k; tol=5%
R2: res; 1k; tol=5%
R3: res; 1k; tol=5%
R4: res; 10k; tol=5%
R5: res; 2k2; tol=5%
R6: res; 1k; tol=5%
R8: res; 1k; tol=5%
R9: res; 2k2; tol=5%
U1: lm358
V1: voltage; PWL(1 14 3.77 14 3.78 37 13.43 37 13.44 14)
V3: voltage; PWL(1 5 2 7 3 9 4 12 5 14 6 17 7 15 8 13 9 12 10 11 11 10 12 7 13 5 14 4)
Named nets: 0, Out, VCC, PWR, Meas_Volt
.tran 0 20 1m 100m
