voloviq/Laboratory_Power_Supply/Analog_Circuit_Simulation_LTSpice/Power_Transformer_Circuit/Power_Tr_Module.asc

D1: diode; 1N4148
D2: diode; 1N4148
D3: diode; 1N4148
D4: diode; 1N4148
V1: voltage; SINE(0 12.4 50)
Named nets: 0
.tran 0 500 1 10m
