voloviq/Laboratory_Power_Supply/Analog_Circuit_Simulation_LTSpice/Transformer_Windings_Switching/Base_On_SN1500-APO.asc

C1: cap; 1000µF
C2: cap; 2200µF
C3: cap; 470nF
C4: cap; 2200µF
D1: schottky; MBR20100CT
D2: zener; 1N750
DR1: schottky; MBR20100CT
DR2: schottky; MBR20100CT
DR3: schottky; MBR20100CT
DR4: schottky; MBR20100CT
L1: ind; 20mH
M1: pmos; IRF7207
Q2: npn; BC547B
R2: res; 1k
R3: res; 10k
R4: res; 4k7
R5: res; 10k
R6: res; 1Meg
R8_LOAD: res; 100R
V1: voltage; SINE(0 14 50)
V2: voltage; SINE(0 14 50)
V3: voltage; 5V
V4: voltage; PWL(1 14 2 15 3 16 4 17 5 18 6 19 7 20 8 19 9 18 10 17 11 16 12 15 13 14 14 13)
Named nets: 0, +18V, +18V/+36V, +Uwyj, +5V
.tran 0 15 10m 1
Wymuszenia symulacji sumulacji
