voloviq/Laboratory_Power_Supply/Scheme_Pcb/Rev_V4_0/Electronics_Supplier_Module_8V_10VA.sch

## KiCad design Scheme_Pcb/Rev_V4_0/Electronics_Supplier_Module_8V_10VA.sch (2015-05-04)

Schematic: Electronics_Supplier_Module_8V_10VA.sch

Parts:
B1_S1: SPI_IND
C1_S1: 2.2uF/400V
C2_S1: 47uF/50V
C3_S1: 3.3nF/1kV
C4_S1: 1nF
C5_S1, C6_S1: 100uF/16V
D1_S1, D3_S1: 1N4007
D2_S1: C_12V
D4_S1: 1N4148
D5_S1: 1N5816
L1_S1: 68uH/1A
Q1_S1: 13001; TO92
R1_S1, R2_S1: 1R
R3_S1, R7_S1: 30R
R4_S1: 10k
R5_S1: 560k
R6_S1: 67k
R8_S1: 2k

Notes on the sheet:
8V/500mA
Digital part supplier
