voloviq/Laboratory_Power_Supply/Scheme_Pcb/Rev_V4_0/Electronics_Supply_Voltages.sch

## KiCad design Scheme_Pcb/Rev_V4_0/Electronics_Supply_Voltages.sch (2015-05-04)

Schematic: Electronics_Supply_Voltages.sch

Parts:
C25: 10uF/16V
C26, C29, C31: 100uF/6.3V
C27, C30: 10uF/6V3
D5: LED
R31, R33, R34: 2k7
R32: 4k3
R35: 3k3
R36: 1k5
R37: 150R
U7, U8, U9: LM1117

Notes on the sheet:
take from SMPS +8[V]
Main supply
1.8V Voltage Regulator
2.5V Voltage Regulator
3.3V Voltage Regulator
