voloviq/Laboratory_Power_Supply/Scheme_Pcb/Rev_V4_0/Keyboard.sch

## KiCad design Scheme_Pcb/Rev_V4_0/Keyboard.sch (2015-05-04)

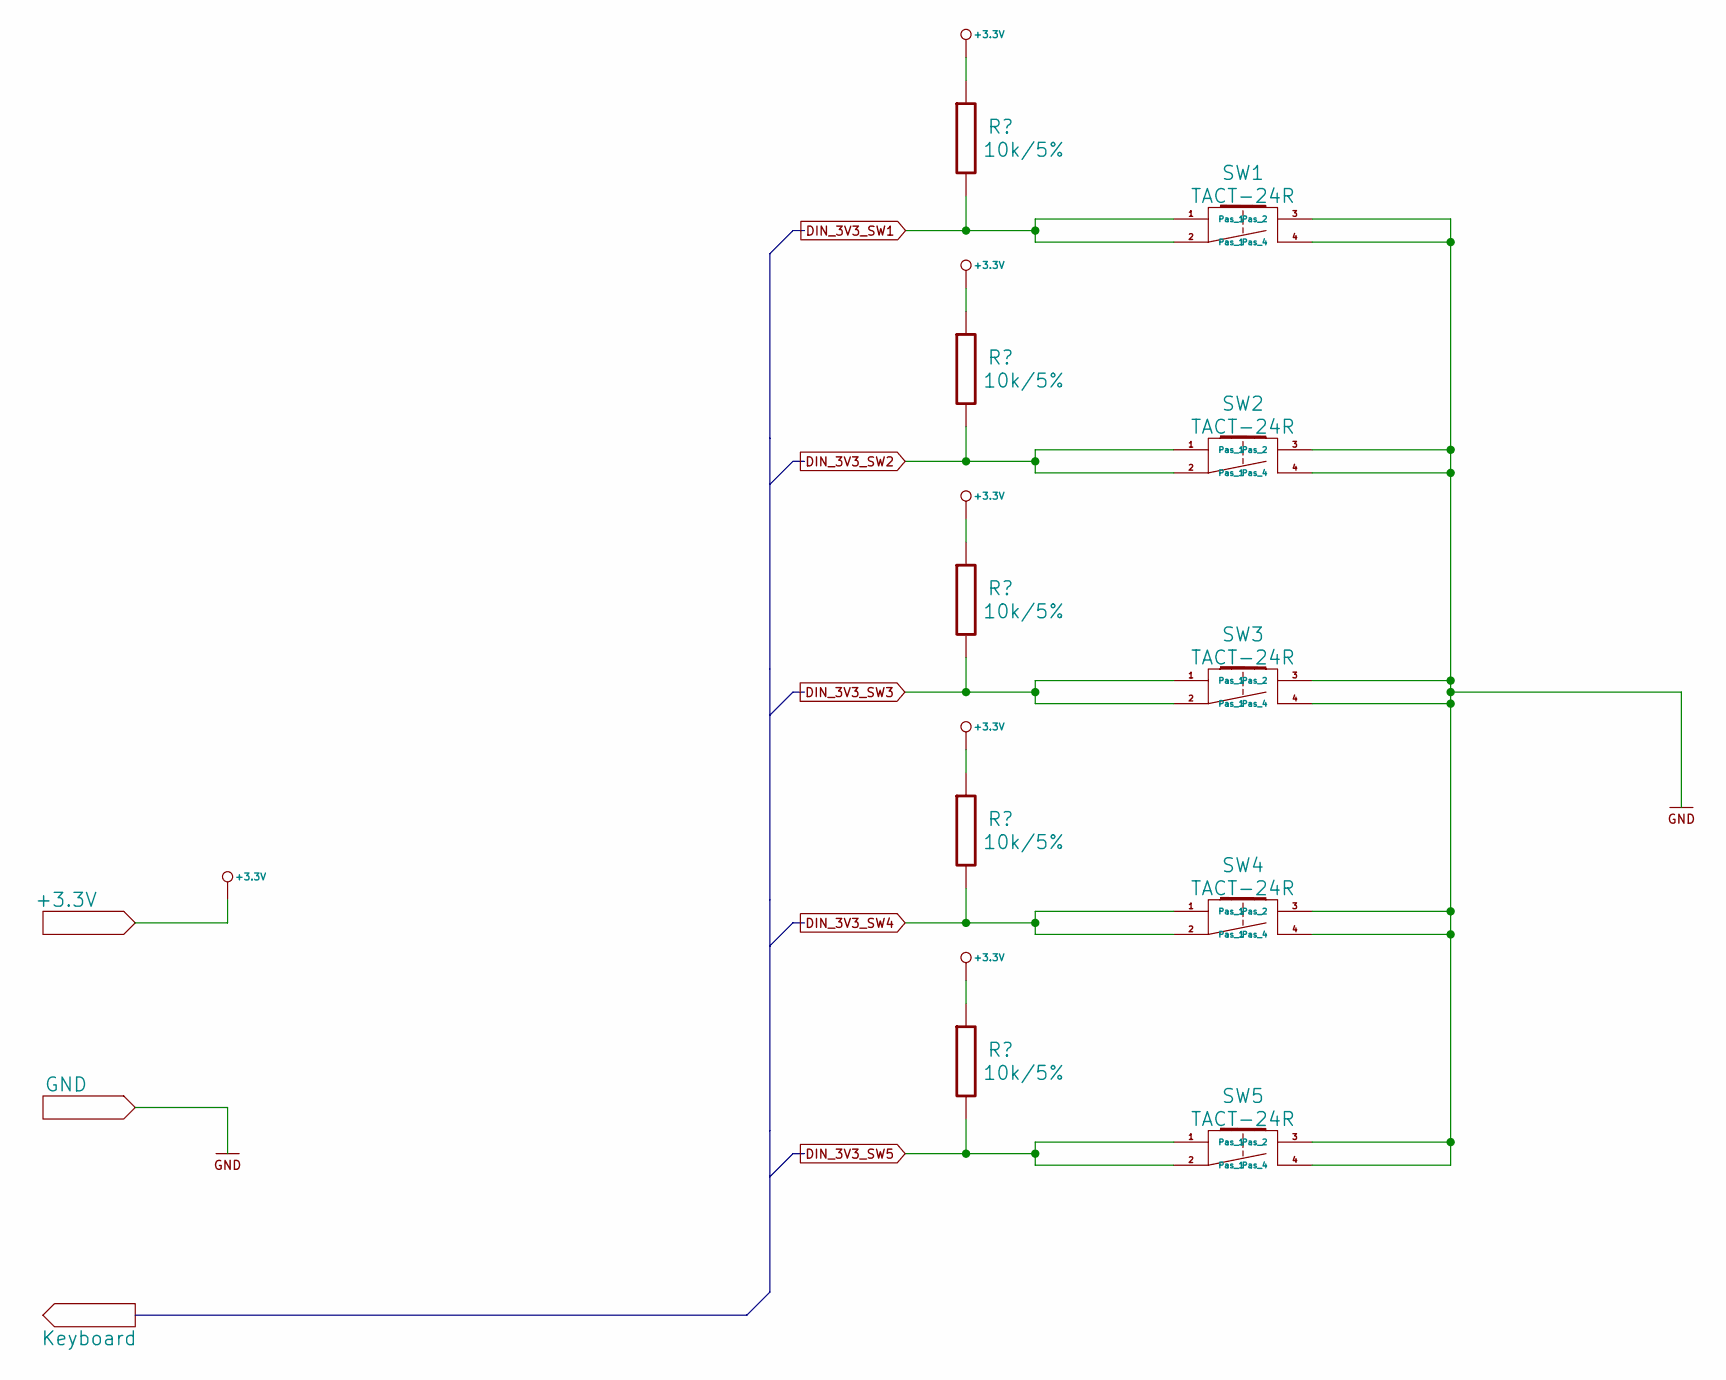
[picture p29: schematic Keyboard.sch]

Parts:
SW1, SW2, SW3, SW4, SW5: TACT-24R

Connections:
DIN_3V3_SW1: SW1.1 (Pas_1), SW1.2 (Pas_1)
DIN_3V3_SW2: SW2.1 (Pas_1), SW2.2 (Pas_1)
DIN_3V3_SW3: SW3.1 (Pas_1), SW3.2 (Pas_1)
DIN_3V3_SW4: SW4.1 (Pas_1), SW4.2 (Pas_1)
DIN_3V3_SW5: SW5.1 (Pas_1), SW5.2 (Pas_1)
GND: SW1.3 (Pas_2), SW1.4 (Pas_4), SW2.3 (Pas_2), SW2.4 (Pas_4), SW3.3 (Pas_2), SW3.4 (Pas_4), SW4.3 (Pas_2), SW4.4 (Pas_4), SW5.3 (Pas_2), SW5.4 (Pas_4)
