voloviq/Laboratory_Power_Supply/Scheme_Pcb/Rev_V4_0/Main_Controller.sch

## KiCad design Scheme_Pcb/Rev_V4_0/Main_Controller.sch (2015-05-04)

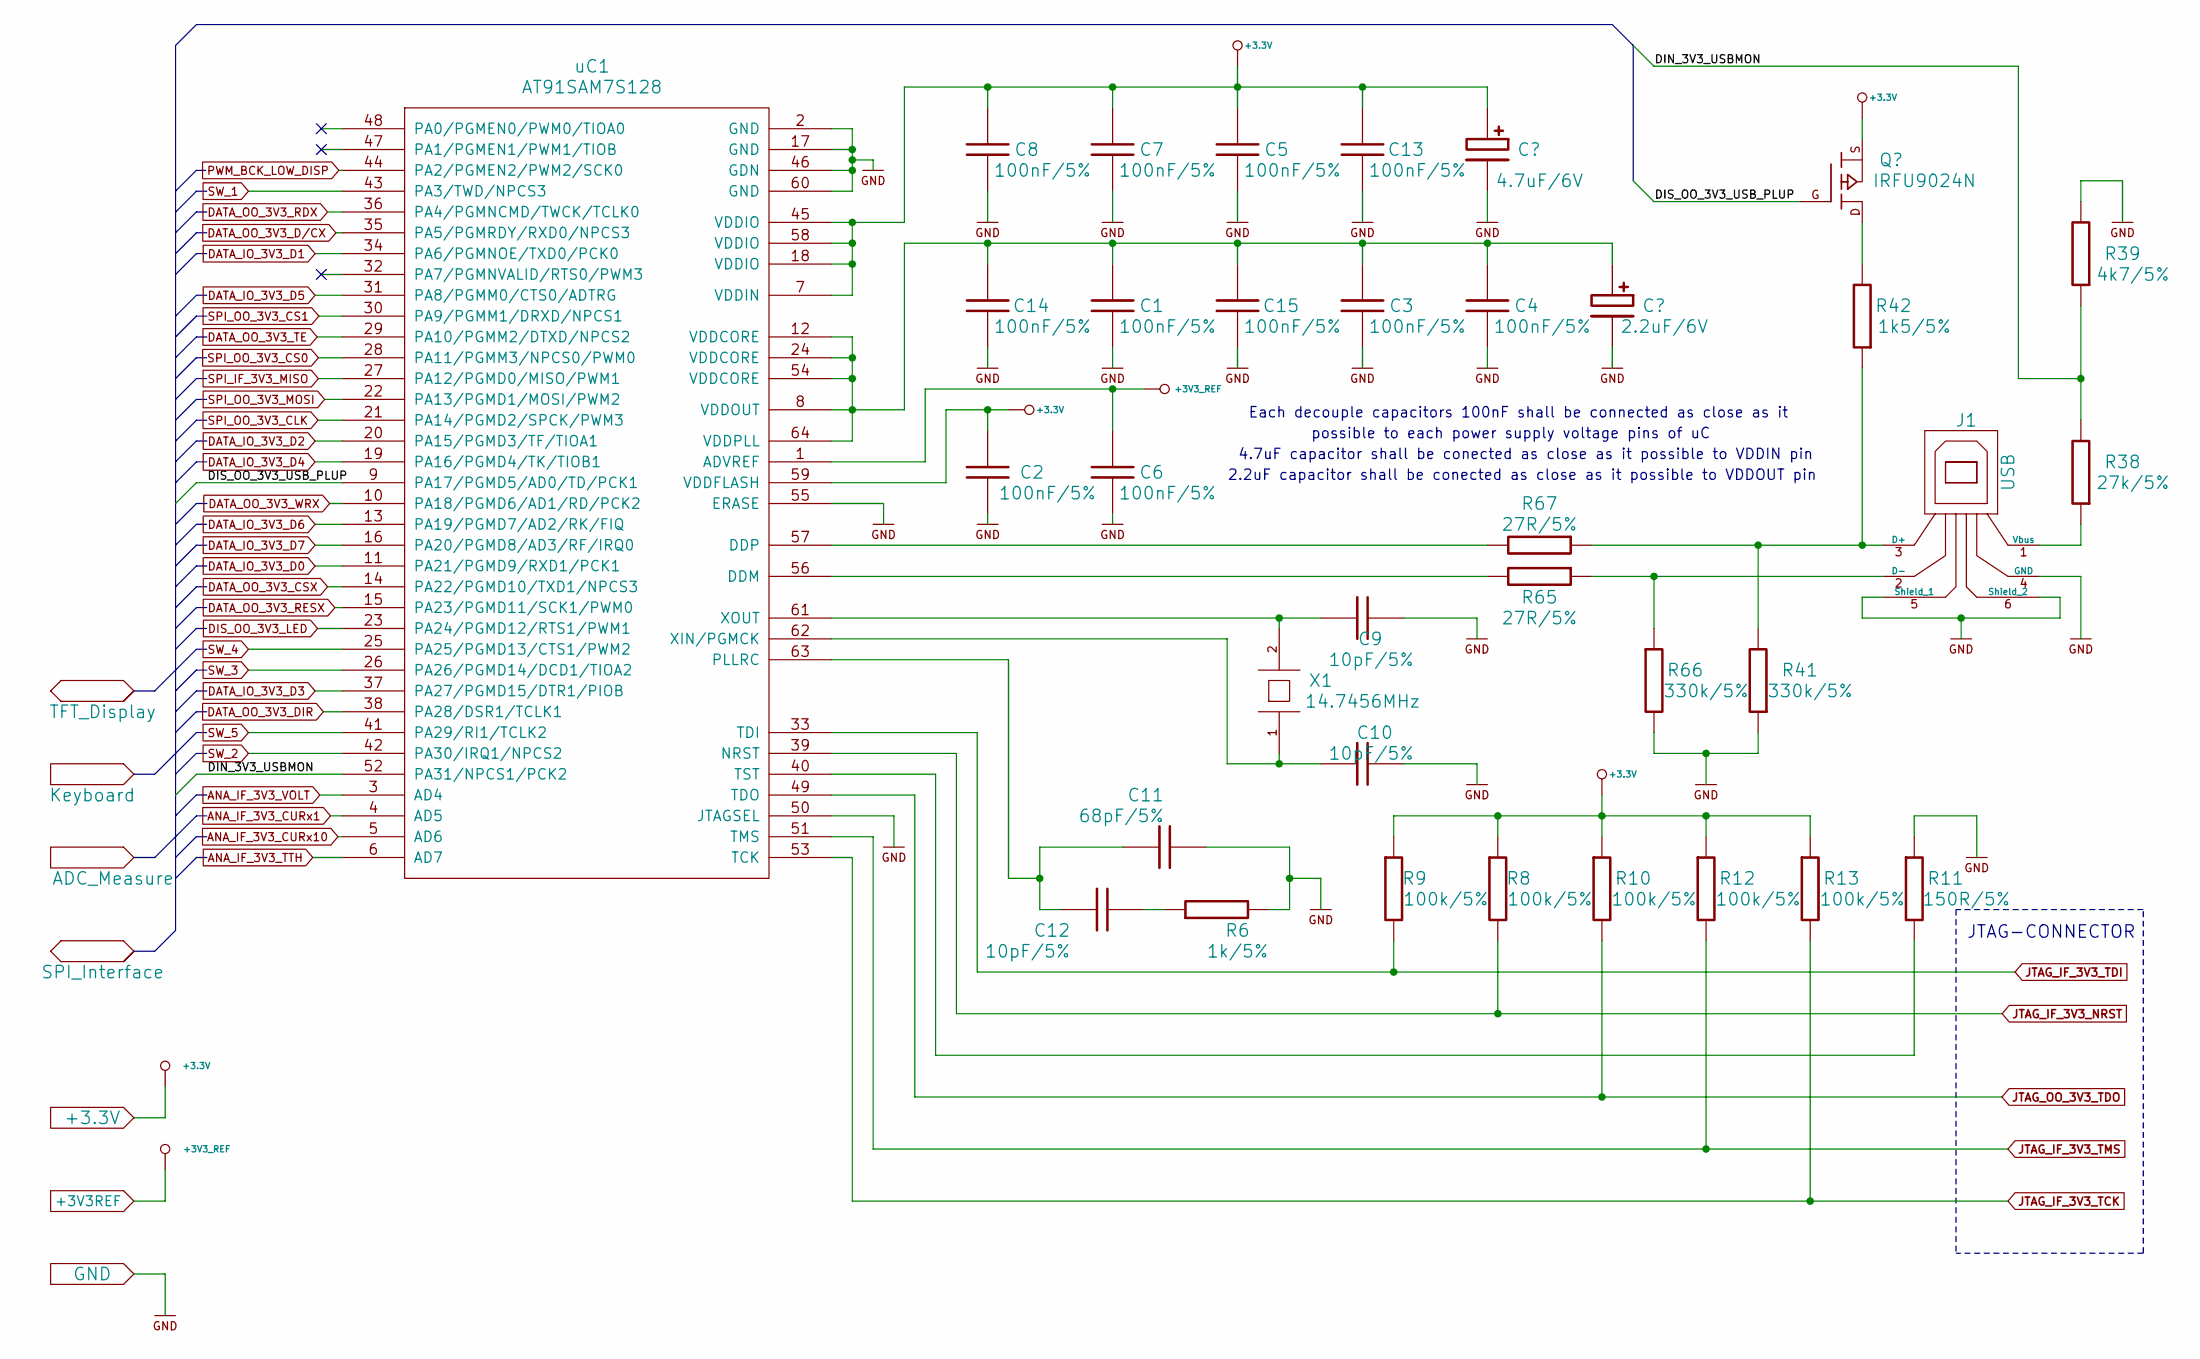
[picture p30: schematic Main_Controller.sch]

Parts:
C1, C2, C3, C4, C5, C6, C7, C8, C13, C14, C15: 100nF/5%
C9, C10, C12: 10pF/5%
C11: 68pF/5%
J1: USB
R6: 1k/5%
R8, R9, R10, R12, R13: 100k/5%
R11: 150R/5%
R38: 27k/5%
R39: 4k7/5%
R41, R66: 330k/5%
R42: 1k5/5%
R65, R67: 27R/5%
X1: 14.7456MHz
uC1: AT91SAM7S128

Connections:
+3.3V: C2.1, C5.2, C7.2, C8.2, C13.2, R8.1, R9.1, R10.1, R12.1, R13.1, uC1.7 (VDDIN), uC1.18 (VDDIO), uC1.45 (VDDIO), uC1.58 (VDDIO), uC1.59 (VDDFLASH)
+3V3_REF: C6.2, uC1.1 (ADVREF)
ANA_IF_3V3_CURx1: uC1.4 (AD5)
ANA_IF_3V3_CURx10: uC1.5 (AD6)
ANA_IF_3V3_TTH: uC1.6 (AD7)
ANA_IF_3V3_VOLT: uC1.3 (AD4)
DATA_IO_3V3_D0: uC1.11 (PA21/PGMD9/RXD1/PCK1)
DATA_IO_3V3_D1: uC1.34 (PA6/PGMNOE/TXD0/PCK0)
DATA_IO_3V3_D2: uC1.20 (PA15/PGMD3/TF/TIOA1)
DATA_IO_3V3_D3: uC1.37 (PA27/PGMD15/DTR1/PIOB)
DATA_IO_3V3_D4: uC1.19 (PA16/PGMD4/TK/TIOB1)
DATA_IO_3V3_D5: uC1.31 (PA8/PGMM0/CTS0/ADTRG)
DATA_IO_3V3_D6: uC1.13 (PA19/PGMD7/AD2/RK/FIQ)
DATA_IO_3V3_D7: uC1.16 (PA20/PGMD8/AD3/RF/IRQ0)
DATA_OO_3V3_CSX: uC1.14 (PA22/PGMD10/TXD1/NPCS3)
DATA_OO_3V3_D/CX: uC1.35 (PA5/PGMRDY/RXD0/NPCS3)
DATA_OO_3V3_DIR: uC1.38 (PA28/DSR1/TCLK1)
DATA_OO_3V3_RDX: uC1.36 (PA4/PGMNCMD/TWCK/TCLK0)
DATA_OO_3V3_RESX: uC1.15 (PA23/PGMD11/SCK1/PWM0)
DATA_OO_3V3_TE: uC1.29 (PA10/PGMM2/DTXD/NPCS2)
DATA_OO_3V3_WRX: uC1.10 (PA18/PGMD6/AD1/RD/PCK2)
DIN_3V3_USBMON: R38.2, R39.1, uC1.52 (PA31/NPCS1/PCK2)
DIS_OO_3V3_LED: uC1.23 (PA24/PGMD12/RTS1/PWM1)
DIS_OO_3V3_USB_PLUP: uC1.9 (PA17/PGMD5/AD0/TD/PCK1)
GND: C1.1, C2.2, C3.1, C4.1, C5.1, C6.1, C7.1, C8.1, C9.2, C10.2, C11.2, C13.1, C14.1, C15.1, J1.4 (GND), J1.5 (Shield_1), J1.6 (Shield_2), R6.2, R11.1, R39.2, R41.1, R66.2, uC1.2 (GND), uC1.17 (GND), uC1.46 (GDN), uC1.50 (JTAGSEL), uC1.55 (ERASE), uC1.60 (GND)
JTAG_IF_3V3_NRST: R8.2, uC1.39 (NRST)
JTAG_IF_3V3_TCK: R13.2, uC1.53 (TCK)
JTAG_IF_3V3_TDI: R9.2, uC1.33 (TDI)
JTAG_IF_3V3_TMS: R12.2, uC1.51 (TMS)
JTAG_OO_3V3_TDO: R10.2, uC1.49 (TDO)
unnamed: C1.2, C3.2, C4.2, C14.2, C15.2, uC1.8 (VDDOUT), uC1.12 (VDDCORE), uC1.24 (VDDCORE), uC1.54 (VDDCORE), uC1.64 (VDDPLL)
unnamed: C9.1, X1.2, uC1.61 (XOUT)
unnamed: C10.1, X1.1, uC1.62 (XIN/PGMCK)
unnamed: C11.1, C12.1, uC1.63 (PLLRC)
unnamed: C12.2, R6.1
unnamed: J1.1 (Vbus), R38.1
unnamed: J1.2 (D-), R65.1, R66.1
unnamed: J1.3 (D+), R41.2, R42.1, R67.1
unnamed: R11.2, uC1.40 (TST)
unnamed: R65.2, uC1.56 (DDM)
unnamed: R67.2, uC1.57 (DDP)
PWM_BCK_LOW_DISP: uC1.44 (PA2/PGMEN2/PWM2/SCK0)
SPI_IF_3V3_MISO: uC1.27 (PA12/PGMD0/MISO/PWM1)
SPI_OO_3V3_CLK: uC1.21 (PA14/PGMD2/SPCK/PWM3)
SPI_OO_3V3_CS0: uC1.28 (PA11/PGMM3/NPCS0/PWM0)
SPI_OO_3V3_CS1: uC1.30 (PA9/PGMM1/DRXD/NPCS1)
SPI_OO_3V3_MOSI: uC1.22 (PA13/PGMD1/MOSI/PWM2)
SW_1: uC1.43 (PA3/TWD/NPCS3)
SW_2: uC1.42 (PA30/IRQ1/NPCS2)
SW_3: uC1.26 (PA26/PGMD14/DCD1/TIOA2)
SW_4: uC1.25 (PA25/PGMD13/CTS1/PWM2)
SW_5: uC1.41 (PA29/RI1/TCLK2)

Notes on the sheet:
2.2uF capacitor shall be conected as close as it possible to VDDOUT pin
4.7uF capacitor shall be conected as close as it possible to VDDIN pin
possible to each power supply voltage pins of uC
Each decouple capacitors 100nF shall be connected as close as it
JTAG-CONNECTOR
