voloviq/Laboratory_Power_Supply/Scheme_Pcb/Rev_V4_0/Main_Power.sch

## KiCad design Scheme_Pcb/Rev_V4_0/Main_Power.sch (2015-05-04)

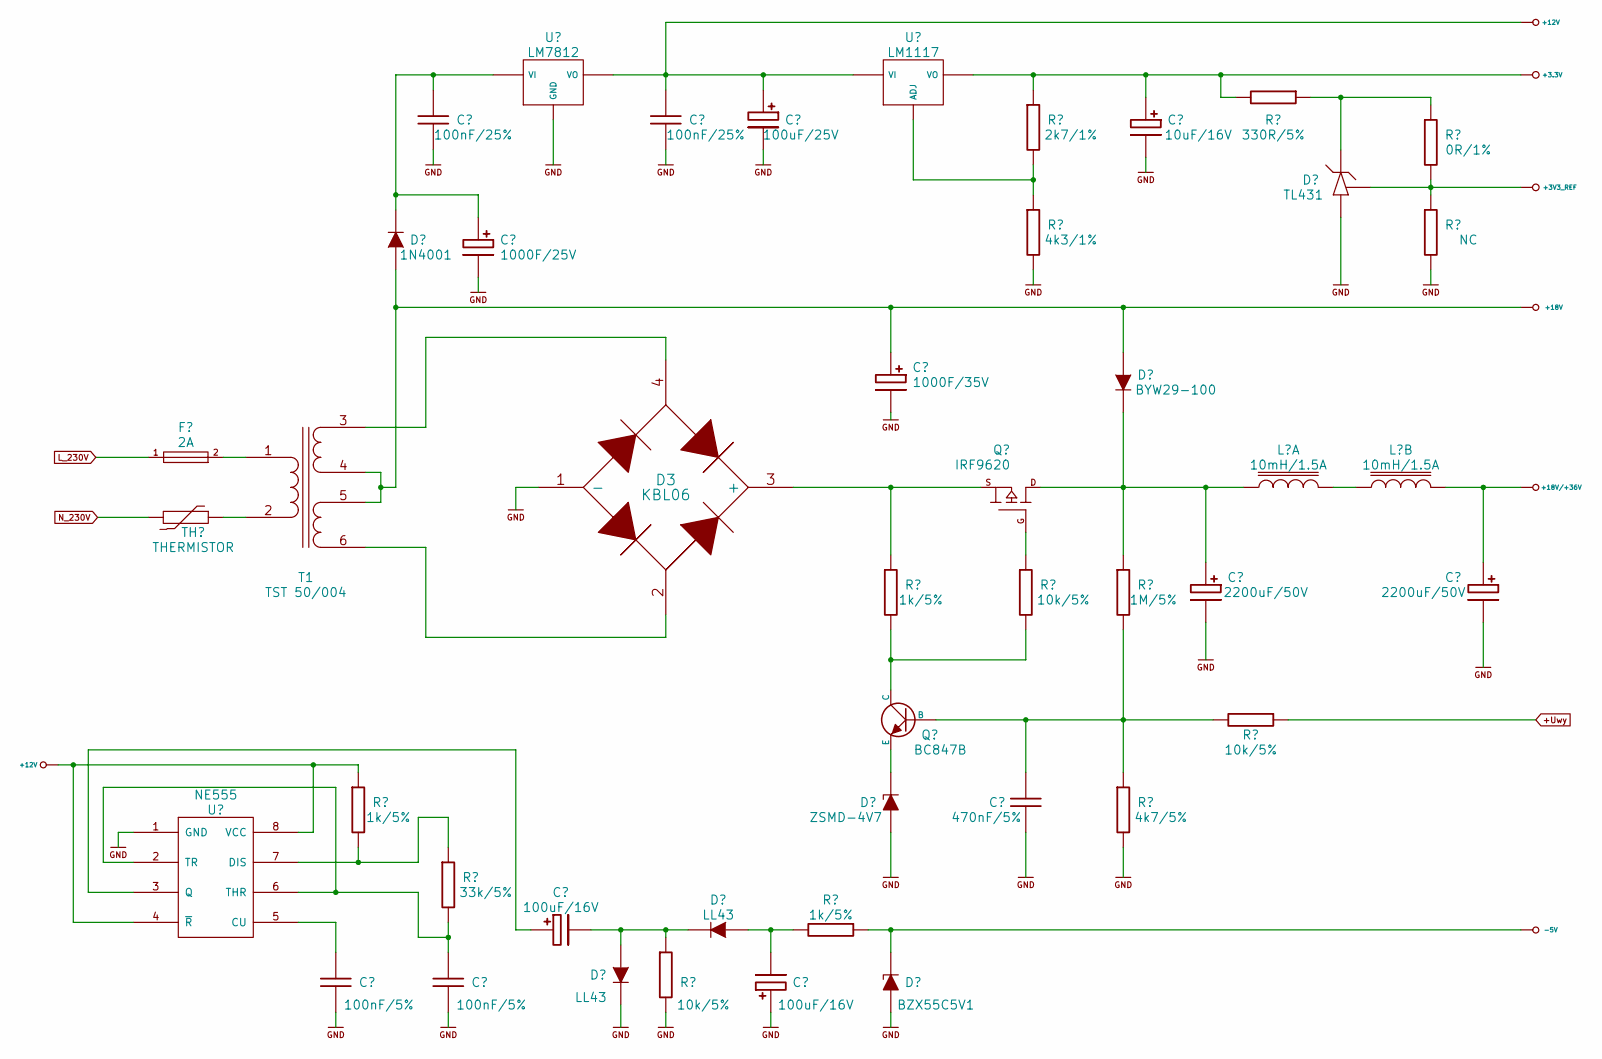
[picture p31: schematic Main_Power.sch]

Parts:
D3: KBL06
T1: TST 50/004

Connections:
+18V: T1.4 (SB), T1.5 (SC)
GND: D3.1 (-)
unnamed: D3.2, T1.6 (SD)
unnamed: D3.4, T1.3 (SA)
