voloviq/Laboratory_Power_Supply/Scheme_Pcb/Rev_V4_0/Power_Regulation_Module.sch

## KiCad design Scheme_Pcb/Rev_V4_0/Power_Regulation_Module.sch (2015-05-04)

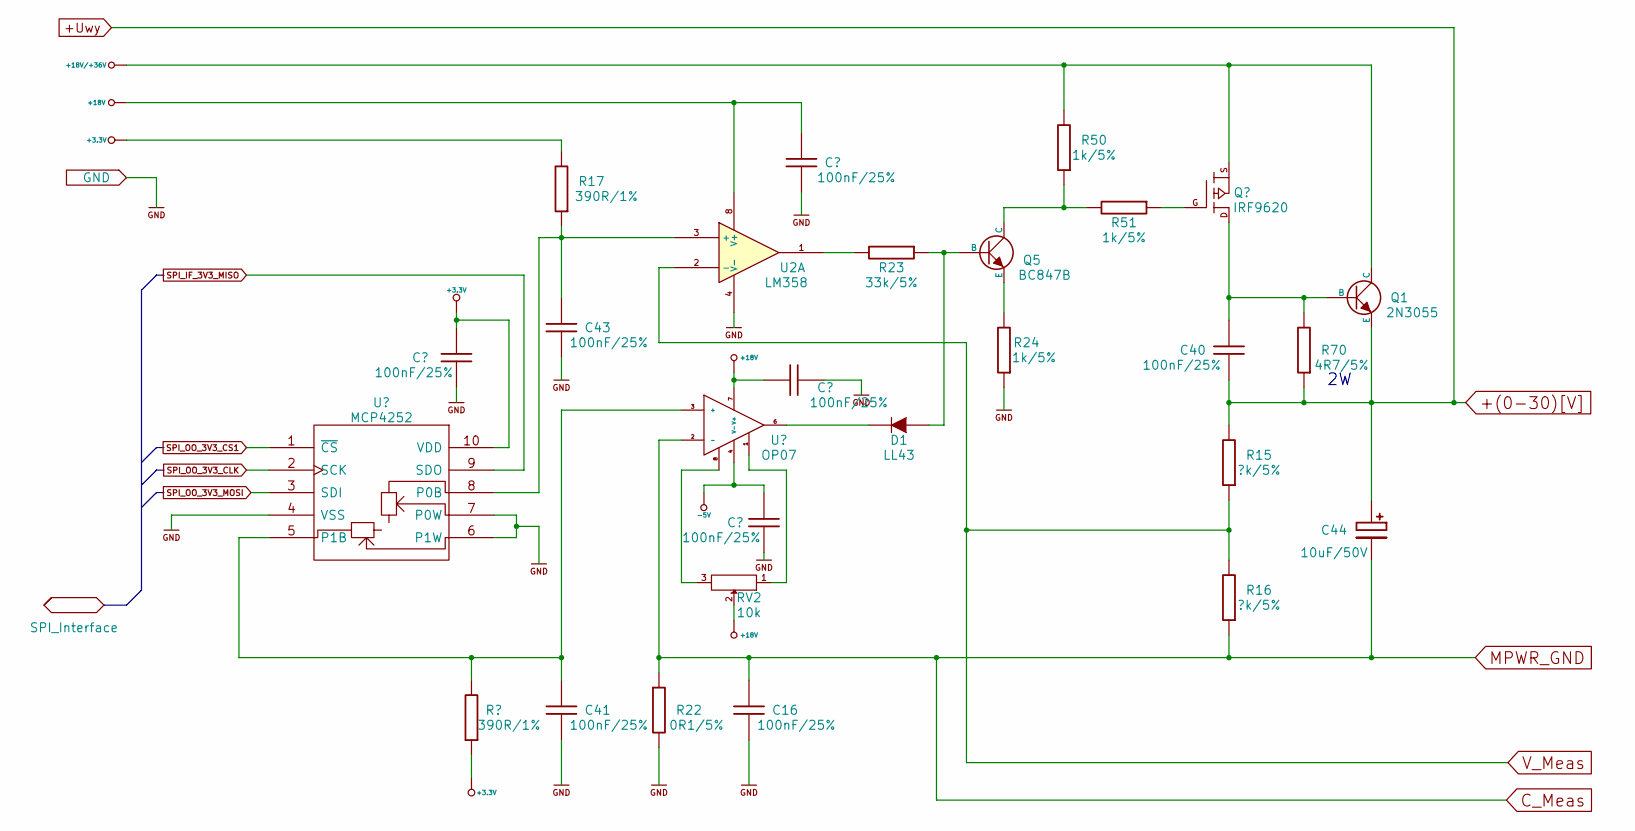
[picture p32: schematic Power_Regulation_Module.sch]

Parts:
C16, C40, C41, C43: 100nF/25%
C44: 10uF/50V
D1: LL43
Q1: 2N3055
Q5: BC847B
R15, R16: ?k/5%
R17: 390R/1%
R22: 0R1/5%
R23: 33k/5%
R24, R50, R51: 1k/5%
R70: 4R7/5%
RV2: 10k
U2: LM358

Connections:
+3.3V: R17.2
+18V: RV2.2, U2.8 (V+)
+18V/+36V: Q1.3 (C), R50.2
+(0-30)[V]: C40.1, C44.1, Q1.1 (E), R15.2, R70.1
C_Meas: C16.1, C44.2, R16.1, R22.1
GND: C16.2, C41.2, C43.2, R22.2, R24.1, U2.4 (V-)
unnamed: C40.2, Q1.2 (B), R70.2
unnamed: C43.1, R17.1, U2.3 (+)
unnamed: D1.1 (A), Q5.2 (B), R23.1
unnamed: Q5.1 (E), R24.2
unnamed: Q5.3 (C), R50.1, R51.2
unnamed: R23.2, U2.1
V_Meas: R15.1, R16.2, U2.2 (-)
