voloviq/Laboratory_Power_Supply/Suplier_Package_3D_Model_Wings3D/Kicad/Package_3D.sch

## KiCad design Suplier_Package_3D_Model_Wings3D/Kicad/Package_3D.sch (2015-05-04)

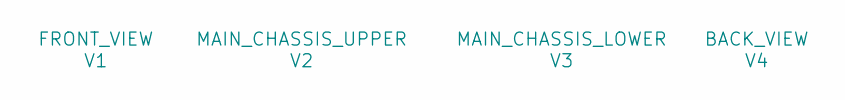
[picture p33: schematic Package_3D.sch]

Parts:
V1: FRONT_VIEW
V2: MAIN_CHASSIS_UPPER
V3: MAIN_CHASSIS_LOWER
V4: BACK_VIEW
